MetronARC/metronarc/DESIGN/DATA/MT-056-SOP-001.pdf

1 | P a g e

Singapore, 179094
[Company Phone Number]
Co. Reg. No. 200918382G
Document No | : | MT-056-SOP-001 | STANDARD OPERATING
| : | March 5, 2025 | PROCEDURE Effective Date
Revision Status | : | | Mechanical Installation on Sparc CNC

Department : Engineering

### 1. PURPOSE :

to know how to assemble each hardware part on sparc cnc.

including what types of components are needed.

### 2. SCOPE :

This document outlines the step-by-step procedure for installing each mechanical sparc cnc part.

### 3. PROCEDURE DETAILS :

No. | Picture | Detail

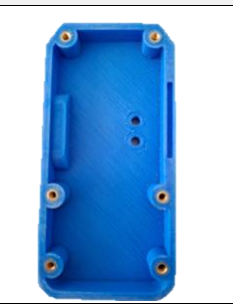
[picture p1: figure]

1 | | Install a 6-piece M4 Nut on the bolt side.

2 | P a g e

[Company Phone Number]
Co. Reg. No. 200918382G

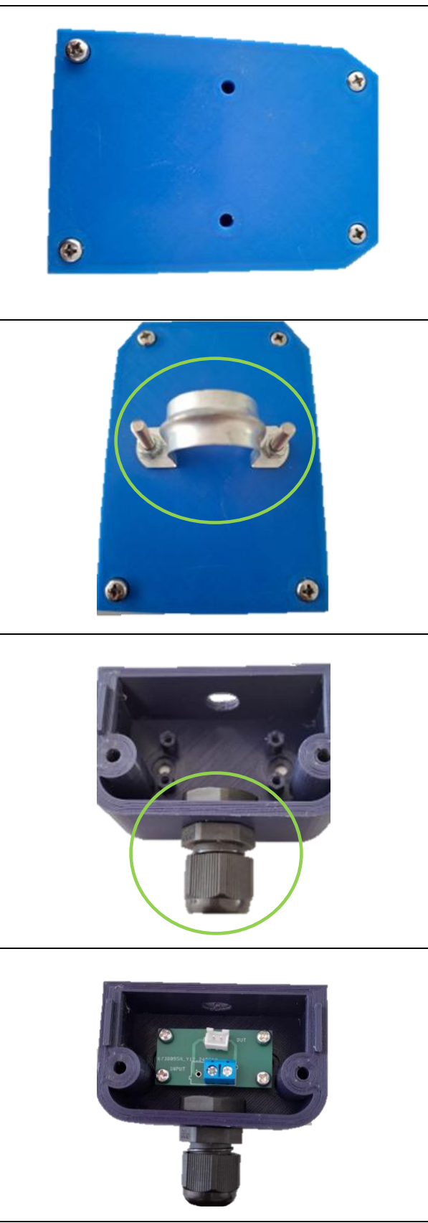
[picture p2: figure]

2 | Install M4 bolts on all 4 sides of the base
4 | Installing omega clamp with 2 M4 bolts.
5 | Installing PG9 at the bottom of the base terminal
| Attach the terminal PCB using M3 bolts on all four sides.

3 | P a g e

[Company Phone Number]
Co. Reg. No. 200918382G

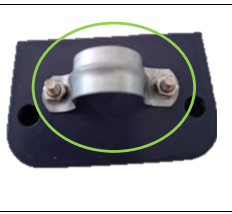
[picture p3: figure]

6 | Attach the omega clamp with the M4 bolt to the rear side of the basse terminal.
