MetronARC/metronarc/DESIGN/DATA/MT-056-SOP-002.pdf

1 | P a g e

Singapore, 179094
[Company Phone Number]
Co. Reg. No. 200918382G
Document No | : | MT-056-SOP-002 | STANDARD OPERATING
| : | March 5, 2025 | PROCEDURE Effective Date
Revision Status | : | | Installation of Components on Sparc CNC PCB

Department : Engineering

### 1. PURPOSE :

to find out the installation of components on Sparc CNC PCBs both PCBs using batteries and PCBs without batteries.

### 2. SCOPE :

This document describes each process and direction of attaching each component to the PCB.

### 3. PROCEDURE DETAILS:

No. | Picture | Detail

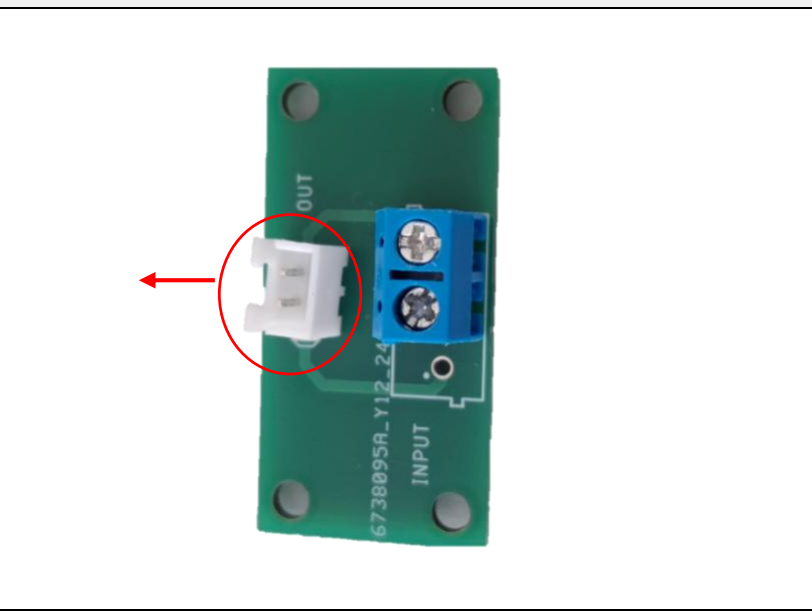
[picture p4: figure]

1 | | Attach the 2-pin JST terminal to the Output pin in the direction of the arrow.

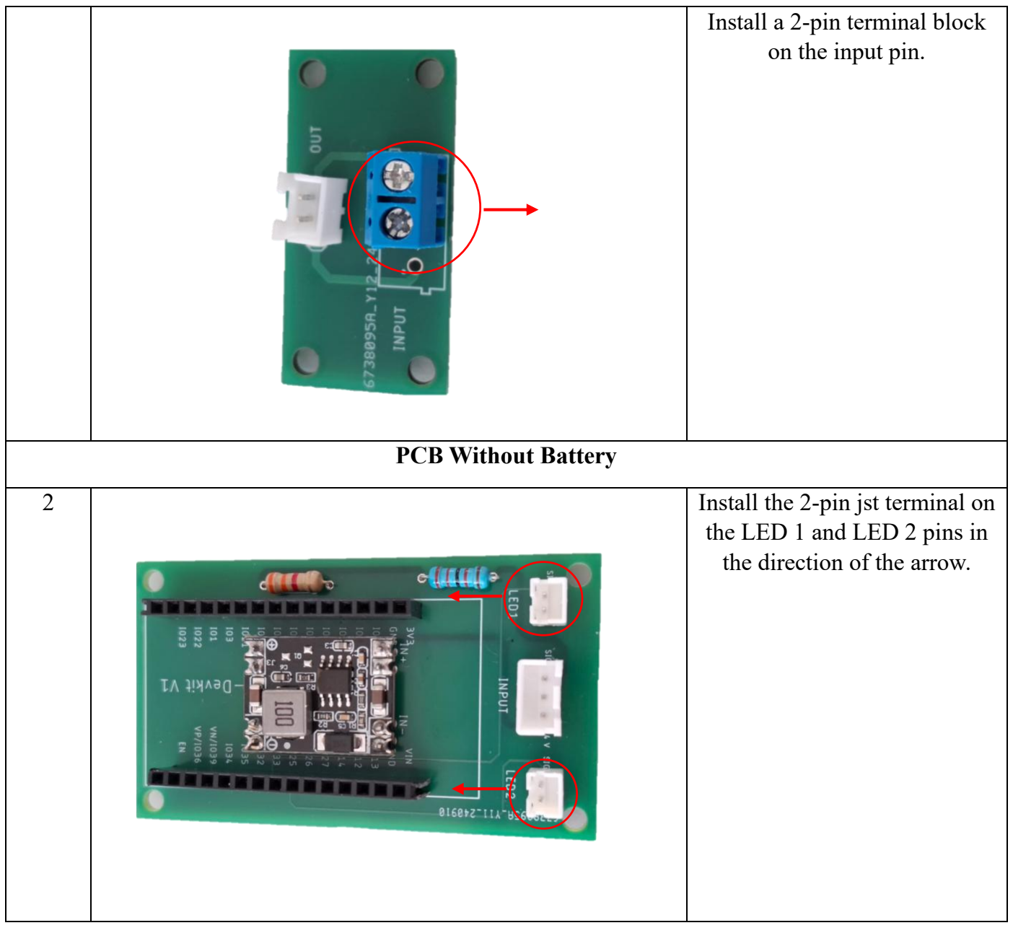
[picture p5: figure]
Install a 2-pin terminal block on the input pin.; PCB Without Battery; Install the 2-pin jst terminal on; the LED 1 and LED 2 pins in the direction of the arrow.

2 | P a g e

[Company Phone Number]
Co. Reg. No. 200918382G

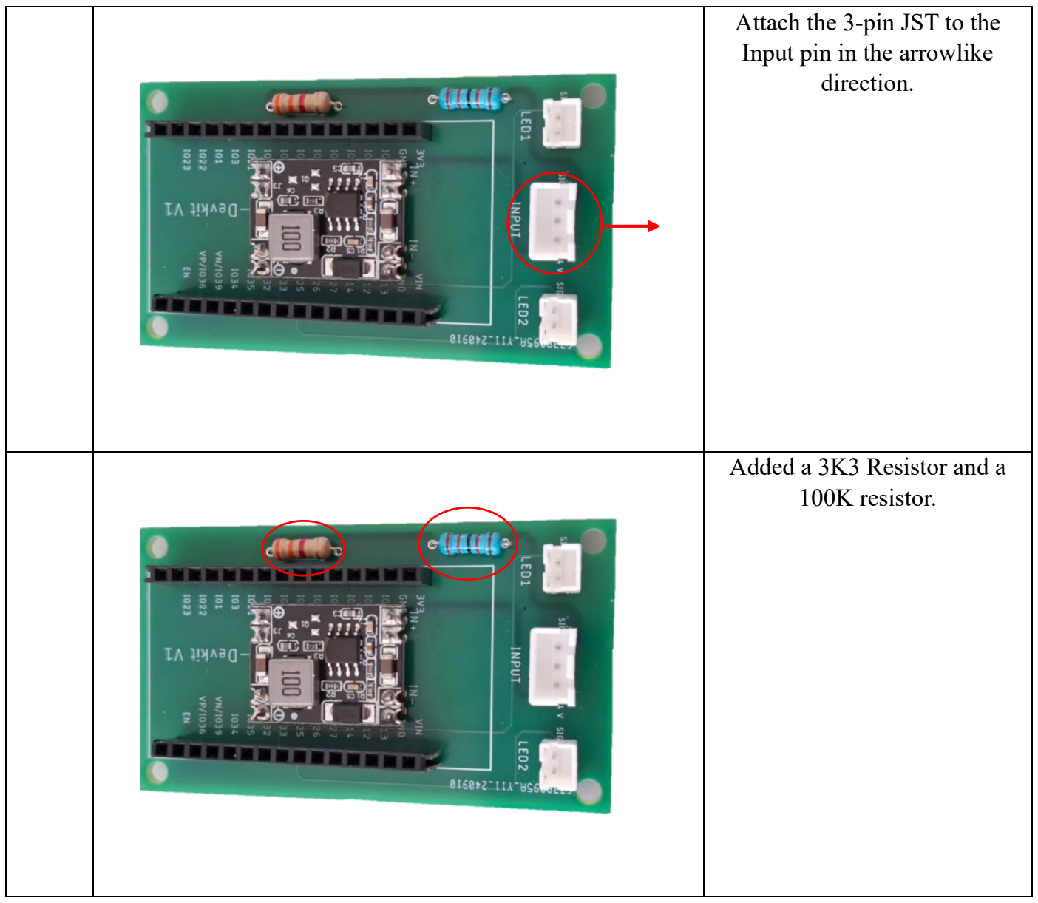
[picture p6: figure]

3 | P a g e

[Company Phone Number]
Co. Reg. No. 200918382G

Attach the 3-pin JST to the Input pin in the arrowlike direction.

Added a 3K3 Resistor and a 100K resistor.

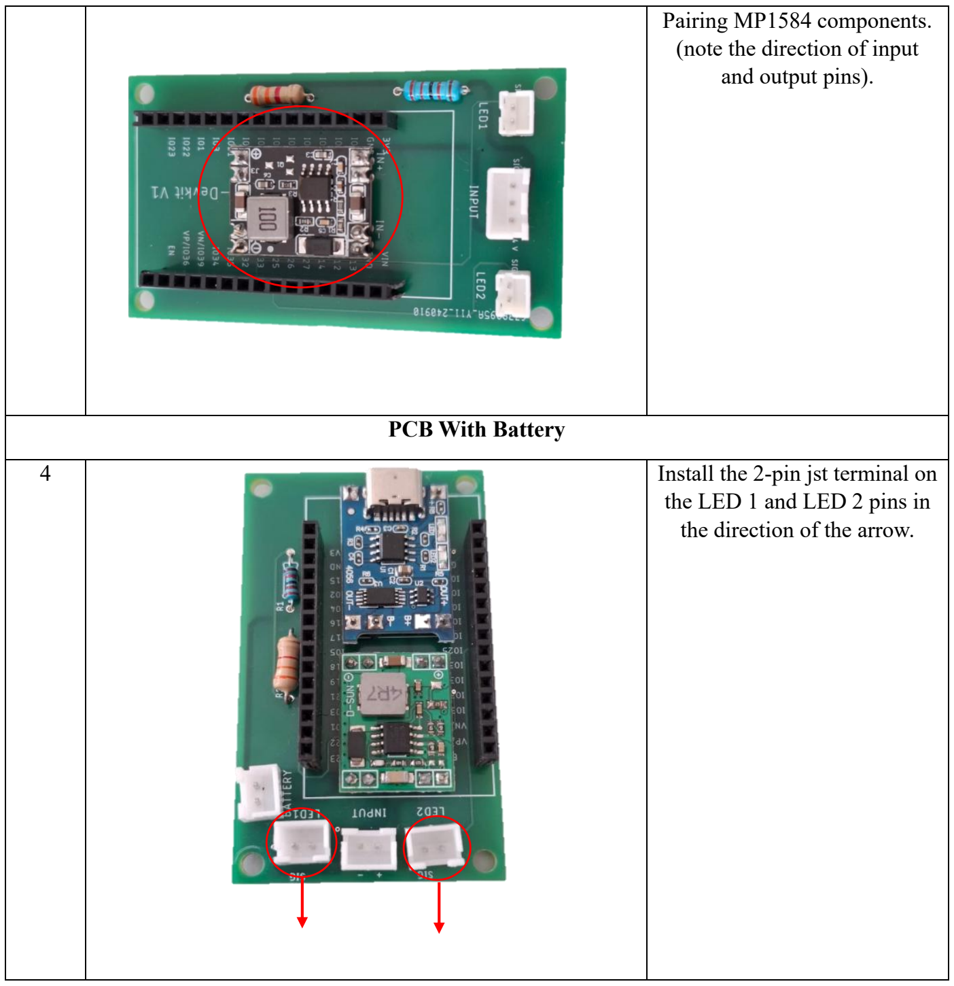
[picture p7: figure]
Pairing MP1584 components. (note the direction of input and output pins).; PCB With Battery; Install the 2-pin jst terminal on; the LED 1 and LED 2 pins in the direction of the arrow.

4 | P a g e

[Company Phone Number]
Co. Reg. No. 200918382G

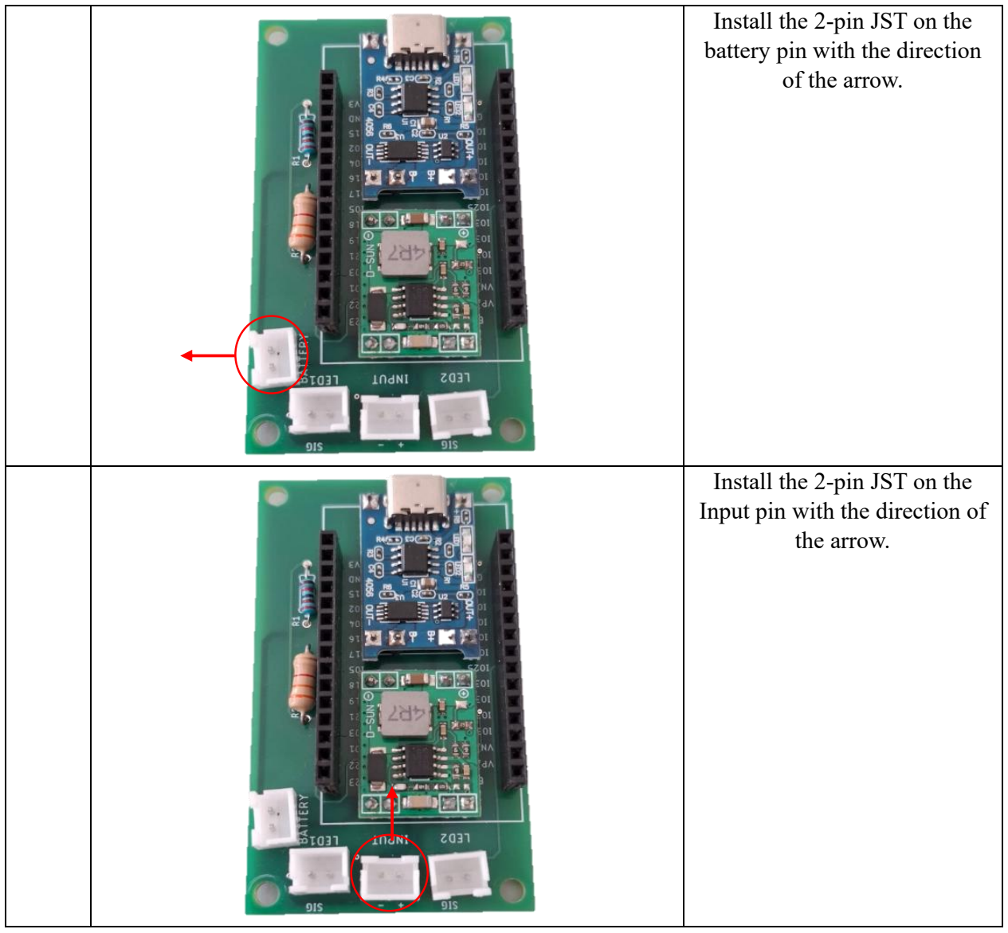
[picture p8: figure]

5 | P a g e

[Company Phone Number]
Co. Reg. No. 200918382G

Install the 2-pin JST on the battery pin with the direction of the arrow.

Install the 2-pin JST on the Input pin with the direction of the arrow.

6 | P a g e

[Company Phone Number]
Co. Reg. No. 200918382G

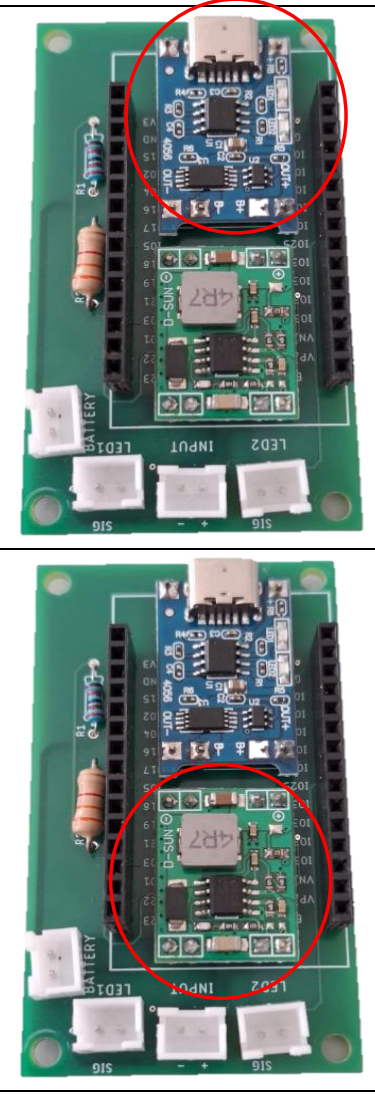
[picture p9: figure]

Install TP4056 components by paying attention to the input and output pin labels on the PCB.

Pairing MP1584 components. (note the direction of input and output pins).
