MetronARC/metronarc/DESIGN/GAMMA/Drawing/MTP-056-001-01.pdf

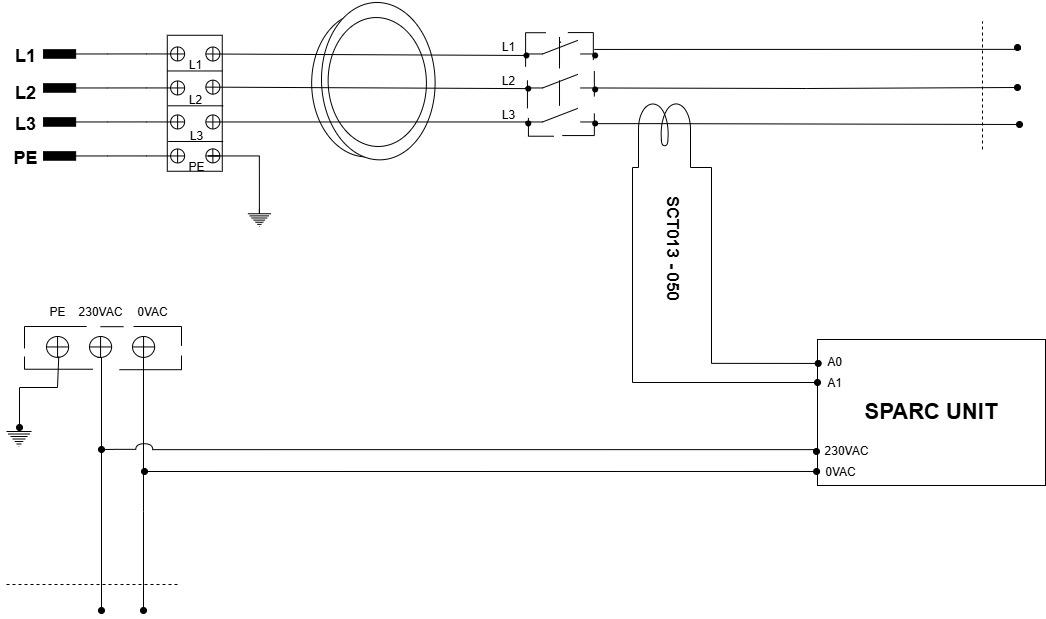
[picture p10: figure]

1 | 30-JAN-2025 | RDP | RR | RR | ISSUED FOR REVIEW
Revision | Date | Drawn By | Checked By | Approved By | Description of Revison
TECHNOLOGY | 1 North Bridge Road #18-06 High Street Centre

Singapore, 179094

Tittle:

### SPARC GAMMA Installation Wiring Diagram

Drawing Number: | Size :
MTP-056-001-01 | A4
