MetronARC/metronarc/DESIGN/CNC/Drawing/Image/Draw Isometric.JPG

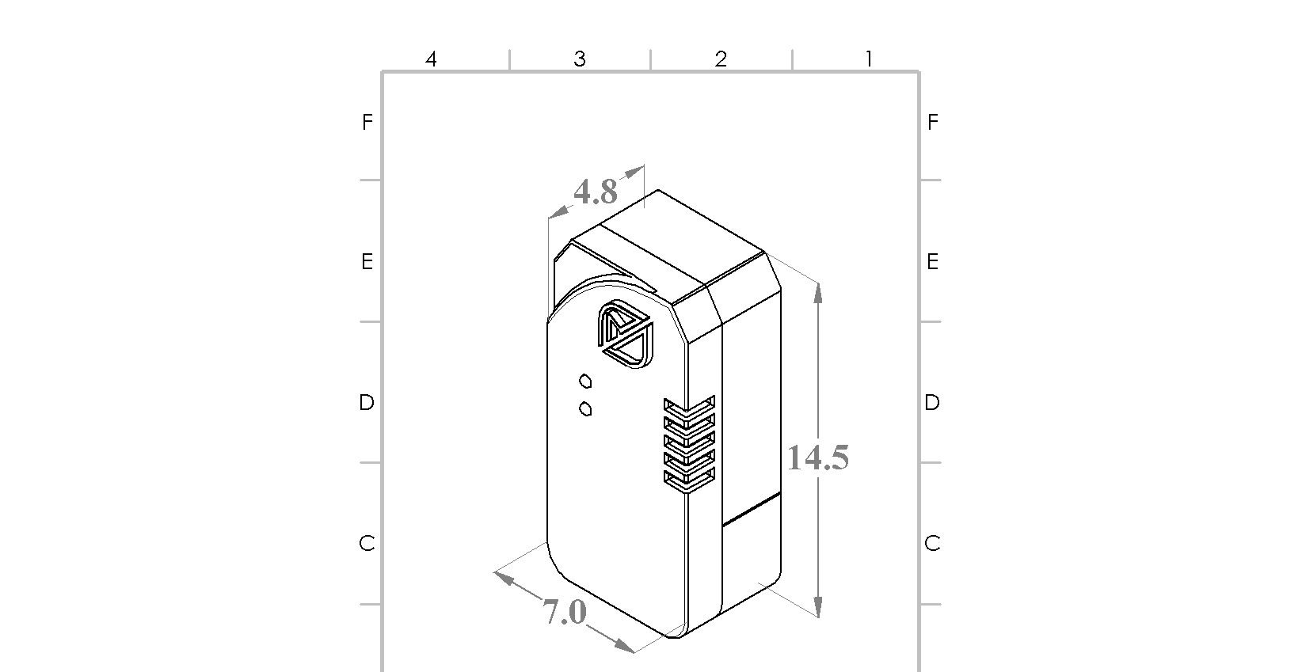
DESIGN/CNC/Drawing/Image/Draw Isometric.JPG
