MetronARC/metronarc/DESIGN/CNC/Drawing/Image/Drawing tampak belakang.JPG

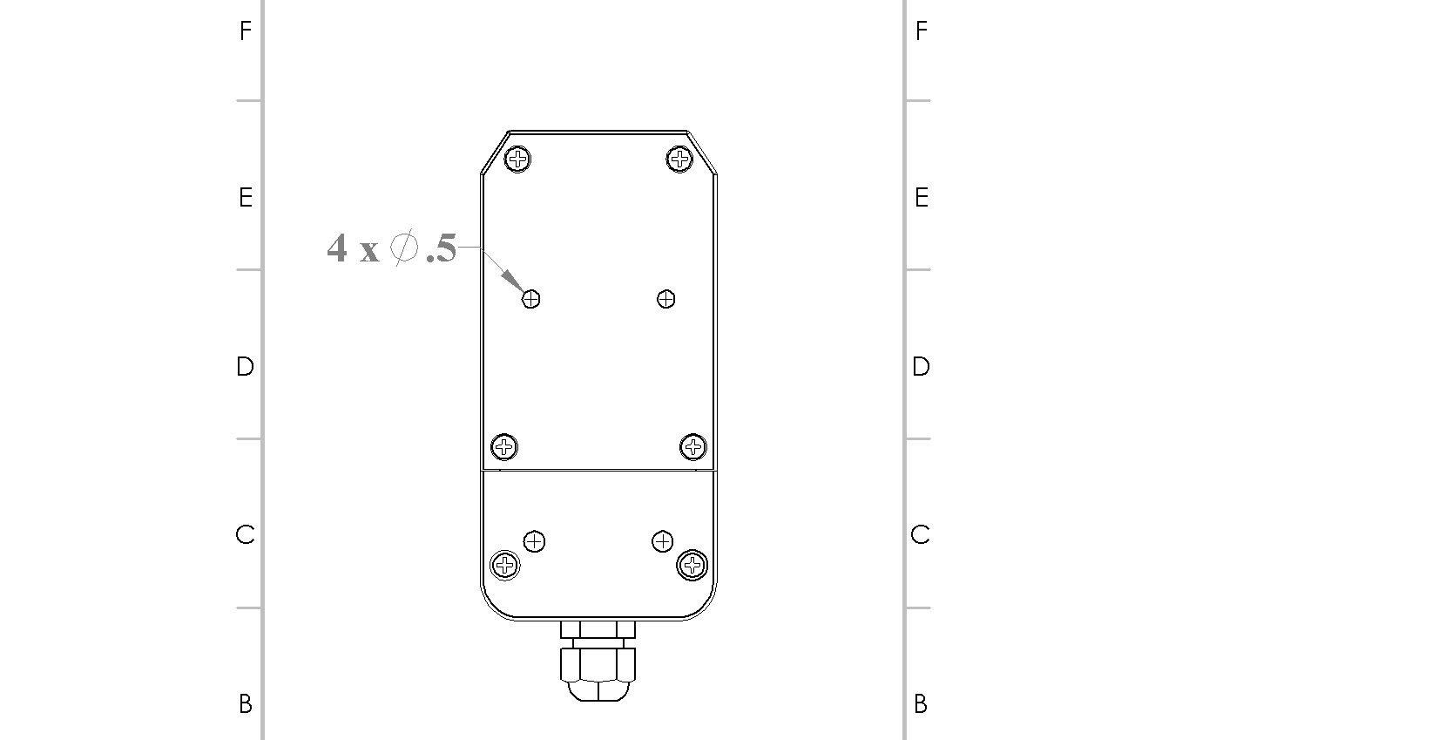
DESIGN/CNC/Drawing/Image/Drawing tampak belakang.JPG
