MetronARC/metronarc/DESIGN/CNC/Drawing/Image/Isometric.JPG

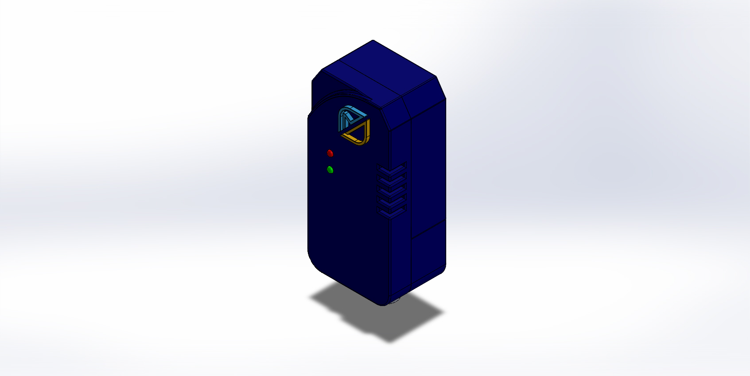
DESIGN/CNC/Drawing/Image/Isometric.JPG
