MetronARC/metronarc/DESIGN/CNC/Drawing/Image/Tampak Depan.JPG

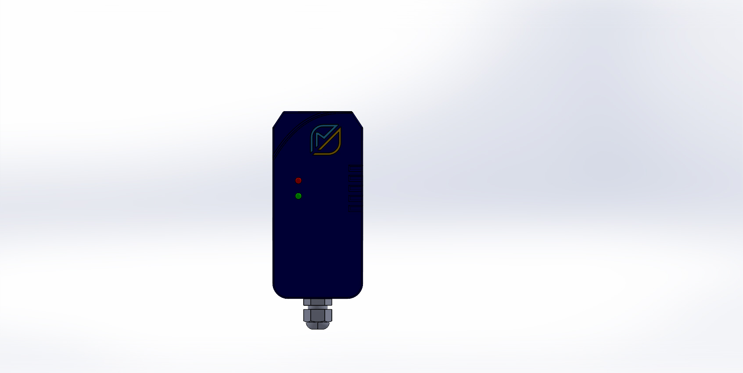
DESIGN/CNC/Drawing/Image/Tampak Depan.JPG
