MetronARC/metronarc/DESIGN/CNC/Drawing/Image/Tampak Samping.JPG

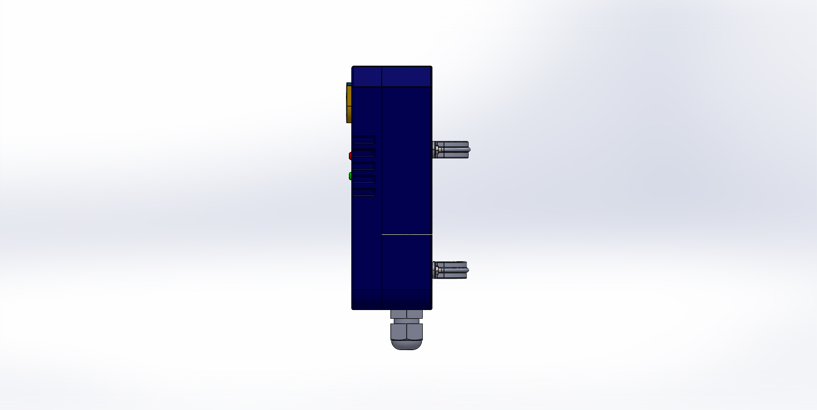
DESIGN/CNC/Drawing/Image/Tampak Samping.JPG
