MetronARC/metronarc/DESIGN/GAMMA/Drawing/Deoan (tampak LED).JPG

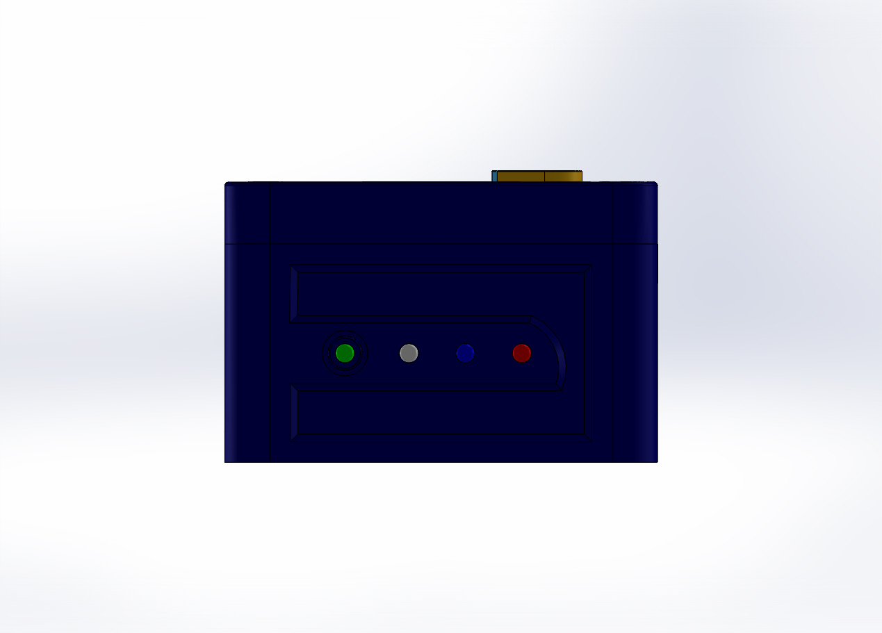
DESIGN/GAMMA/Drawing/Deoan (tampak LED).JPG
