MetronARC/metronarc/DESIGN/GAMMA/Drawing/Drawing Base.JPG

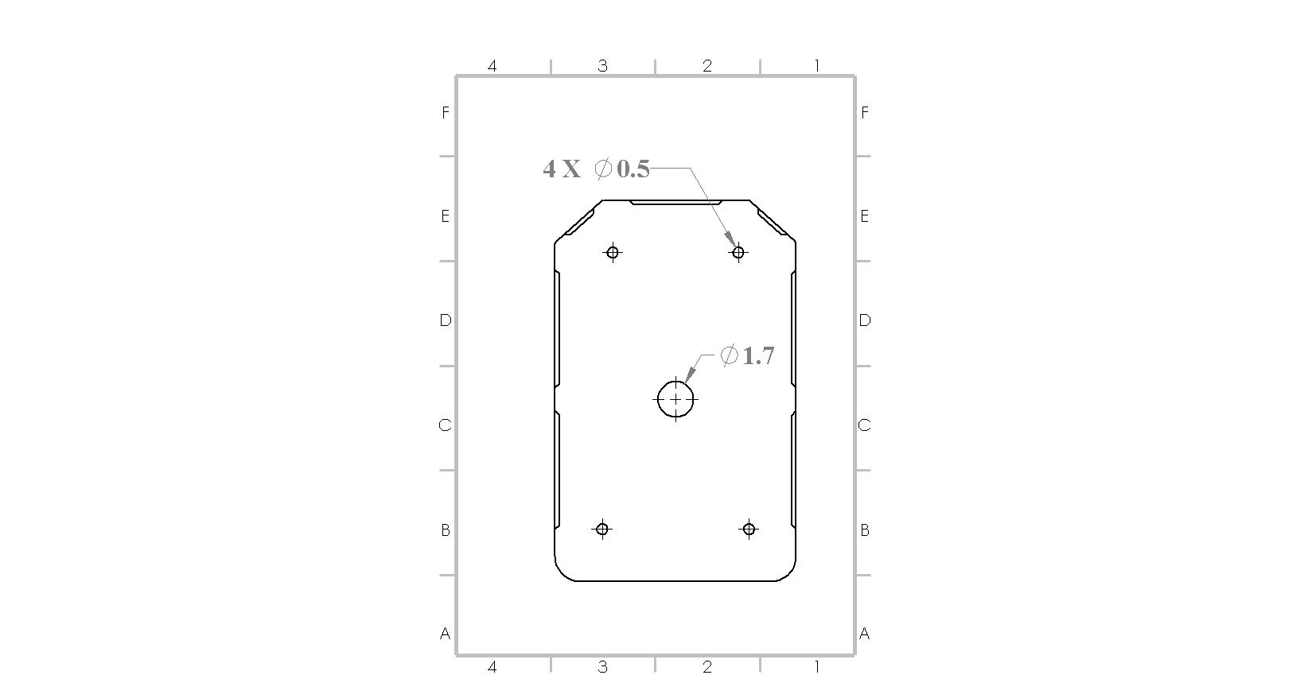
DESIGN/GAMMA/Drawing/Drawing Base.JPG
