MetronARC/metronarc/DESIGN/GAMMA/Drawing/Drawing Depan  (tampak LED).JPG

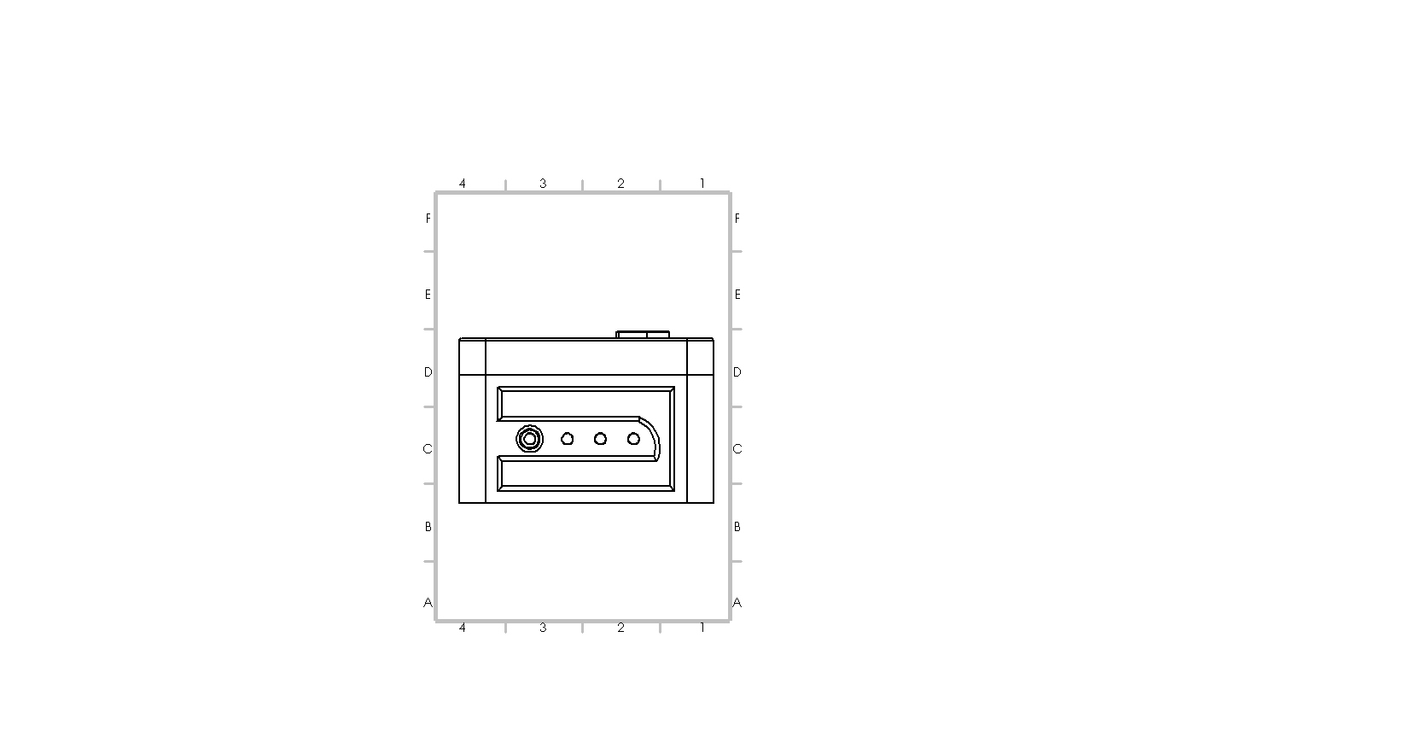
DESIGN/GAMMA/Drawing/Drawing Depan (tampak LED).JPG
