MetronARC/metronarc/DESIGN/GAMMA/Drawing/Drawing Isometric.JPG

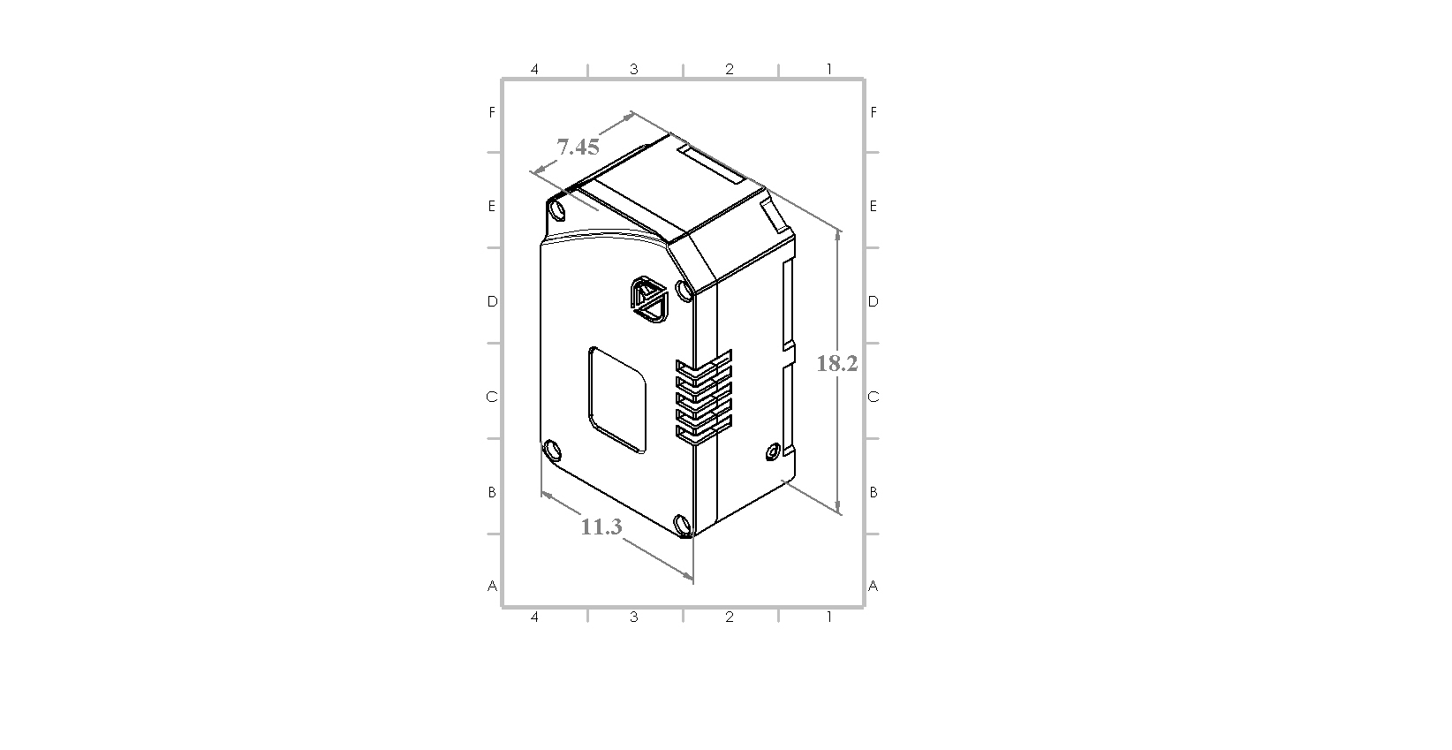
DESIGN/GAMMA/Drawing/Drawing Isometric.JPG
