MetronARC/metronarc/DESIGN/BETA/File STL/Template TOP.STL

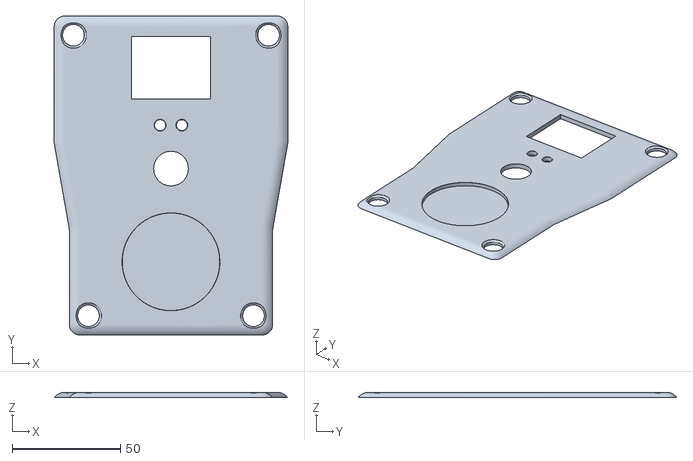
[picture p20: CAD file, 2025-04-08]
DESIGN/BETA/File STL/Template TOP.STL
107.7 x 147.1 x 2.50
