MetronARC/metronarc/DESIGN/CNC/SolidWorks file/Top Box terminal.SLDPRT

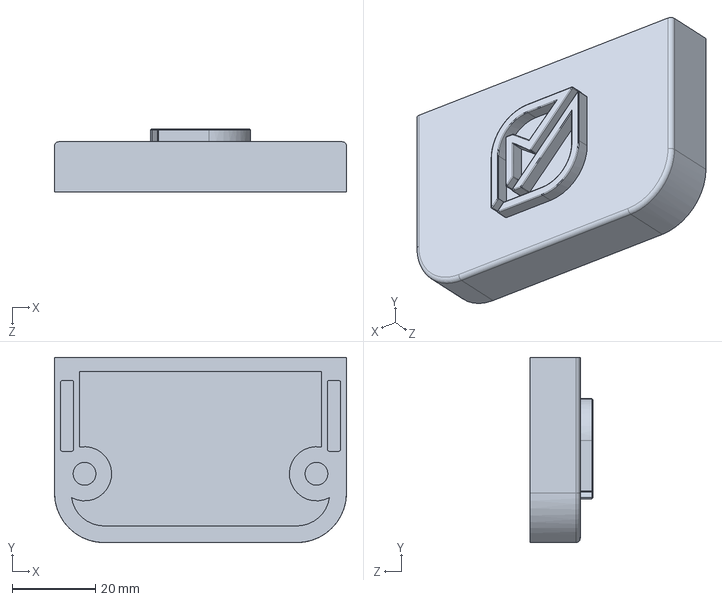
[picture p21: CAD file, 2025-04-08]
DESIGN/CNC/SolidWorks file/Top Box terminal.SLDPRT
70.0 x 44.4 x 15.0 mm
