MetronARC/metronarc/DESIGN/CNC/STL/Bracket.STL

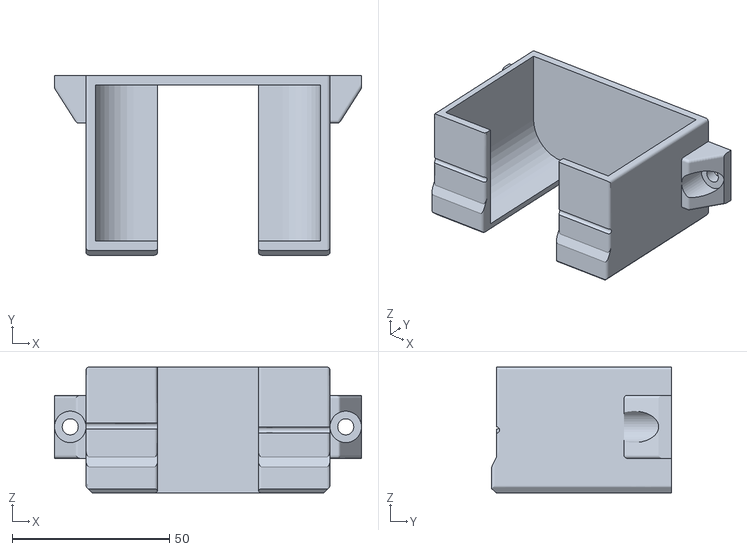
[picture p22: CAD file, 2024-12-26]
DESIGN/CNC/STL/Bracket.STL
97.5 x 57.0 x 40.0
