MetronARC/metronarc/DESIGN/GAMMA/Solidworks file/Spark .M REV.SLDPRT

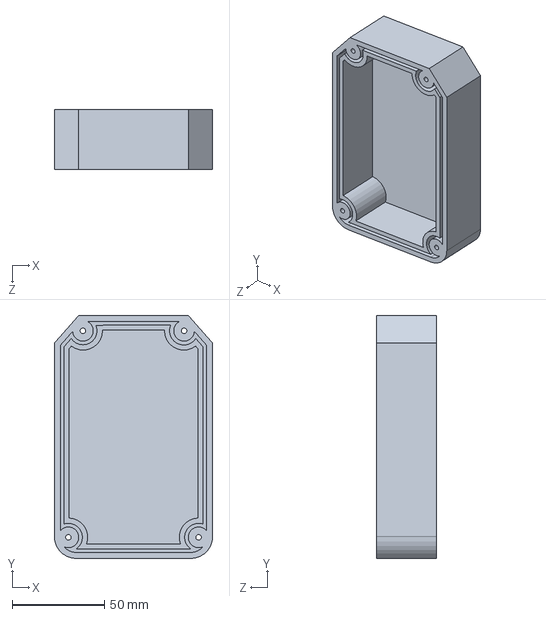
[picture p23: CAD file, 2025-04-08]
DESIGN/GAMMA/Solidworks file/Spark .M REV.SLDPRT
86.0 x 131.9 x 32.5 mm
