MetronARC/metronarc/DESIGN/GAMMA/STL/Spark .M REV2.STL

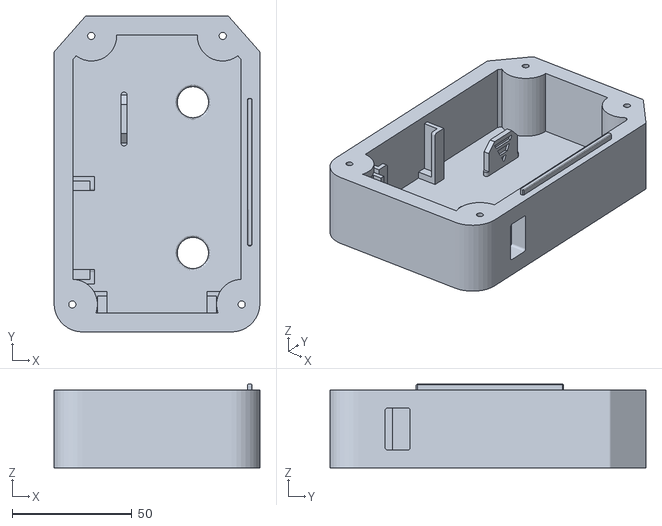
[picture p24: CAD file, 2024-10-15]
DESIGN/GAMMA/STL/Spark .M REV2.STL
86.0 x 131.9 x 35.0
