MetronARC/metronarc/DESIGN/OILID/DESIGN/BASE_Mini Gamma QR.STL

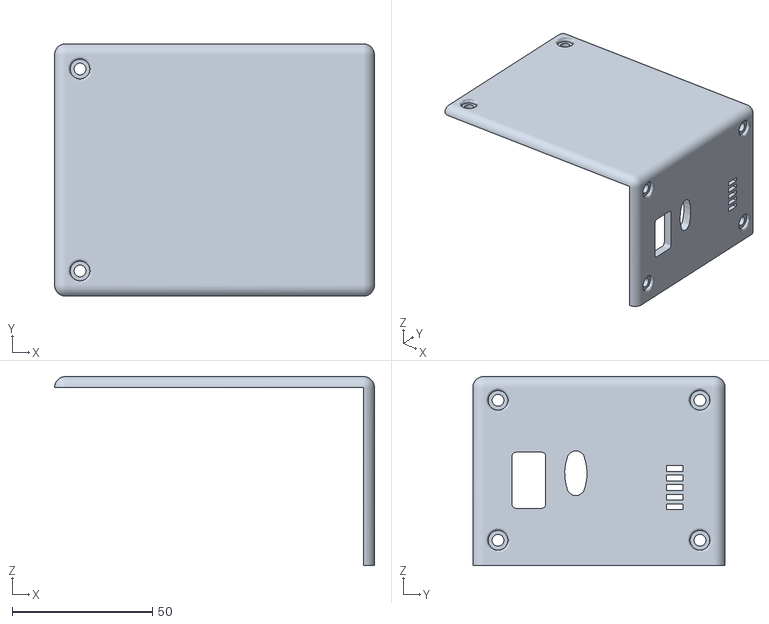
[picture p25: CAD file, 2025-02-19]
DESIGN/OILID/DESIGN/BASE_Mini Gamma QR.STL
114.1 x 90.0 x 67.4
