MetronARC/metronarc/PCB/3D/PCB Terminal.step

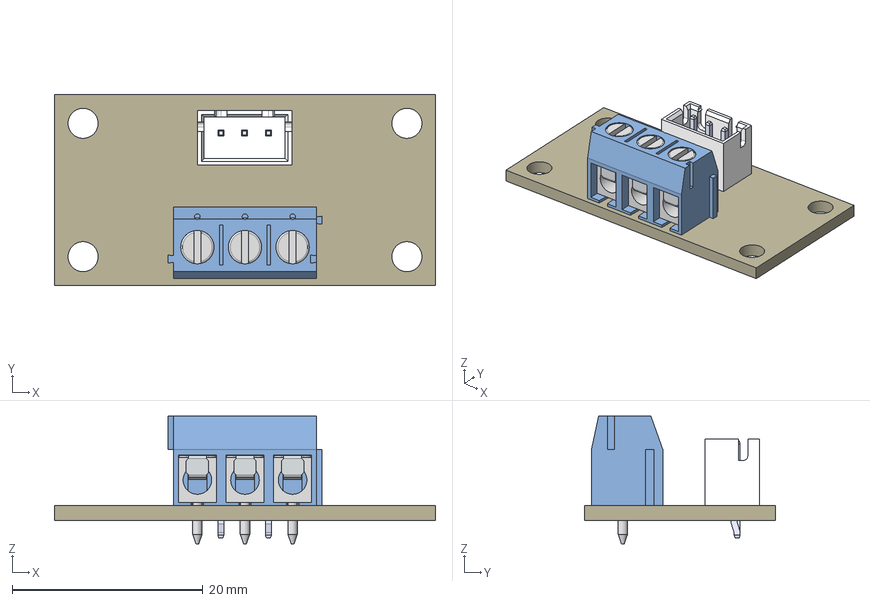
[picture p26: CAD file, 2024-09-09]
PCB/3D/PCB Terminal.step
40.0 x 20.0 x 13.4 mm
Board
Packages
6911027100xx_CAGE x 3
6911027100xx_PIN x 3
6911027100xx_VIS x 3
BxB-XH-A_03
