MetronARC/metronarc/PCB/SCHEMATIC/GAMMA/SCHEMATIC/3D File/SPARC_Gamma_3D PCB Layout v2.stl

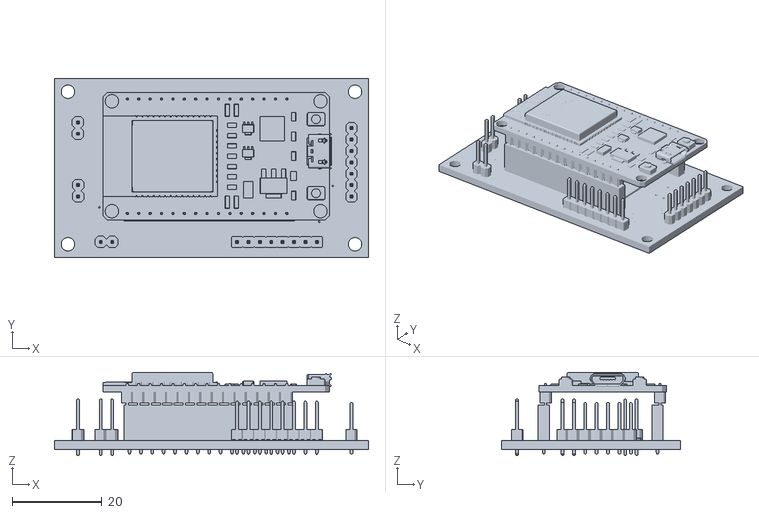
[picture p27: CAD file, 2024-09-09]
PCB/SCHEMATIC/GAMMA/SCHEMATIC/3D File/SPARC_Gamma_3D PCB Layout v2.stl
70.0 x 40.0 x 18.5
