MetronARC/metronarc/DESIGN/BETA/File STL/BASE.STL

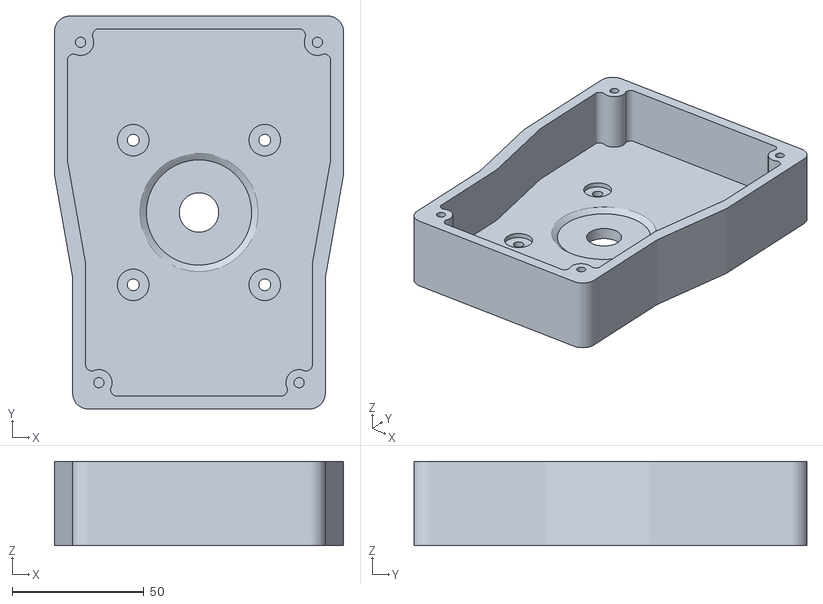
[picture p28: CAD file, 2025-04-08]
DESIGN/BETA/File STL/BASE.STL
110.0 x 149.4 x 32.0
