MetronARC/metronarc/DESIGN/CNC/SolidWorks file/TOP.SLDPRT

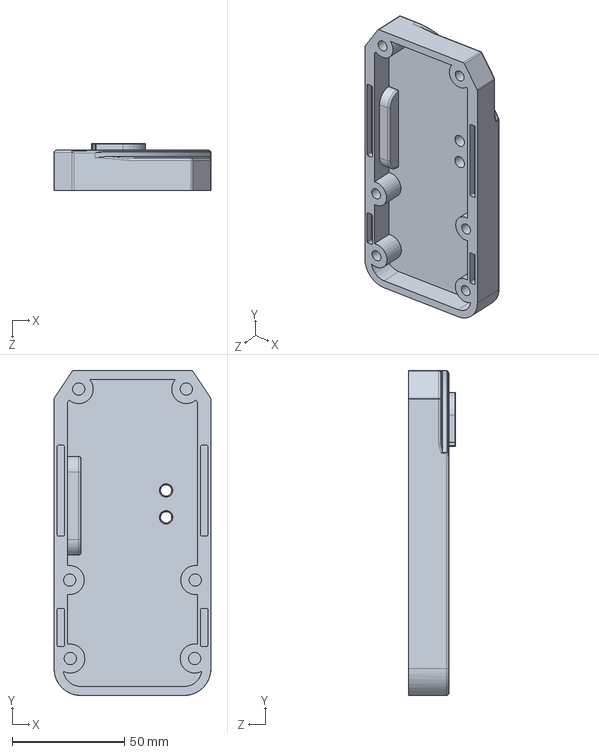
[picture p29: CAD file, 2025-04-08]
DESIGN/CNC/SolidWorks file/TOP.SLDPRT
70.0 x 145.0 x 21.0 mm
