MetronARC/metronarc/DESIGN/CNC/STL/Rev1_L_Con.STL

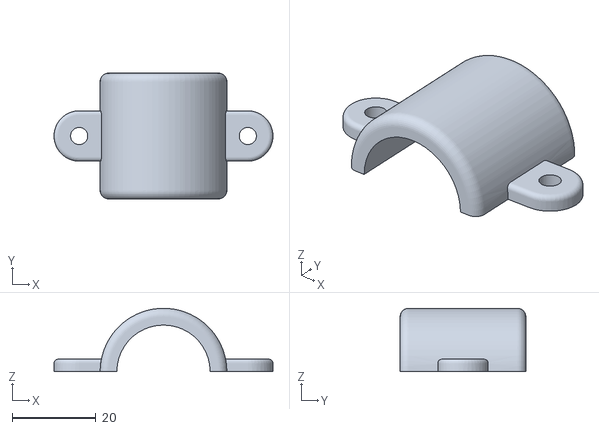
[picture p30: CAD file, 2024-12-11]
DESIGN/CNC/STL/Rev1_L_Con.STL
52.2 x 30.0 x 15.1
