MetronARC/metronarc/DESIGN/GAMMA/Solidworks file/TOP.M REV.SLDPRT

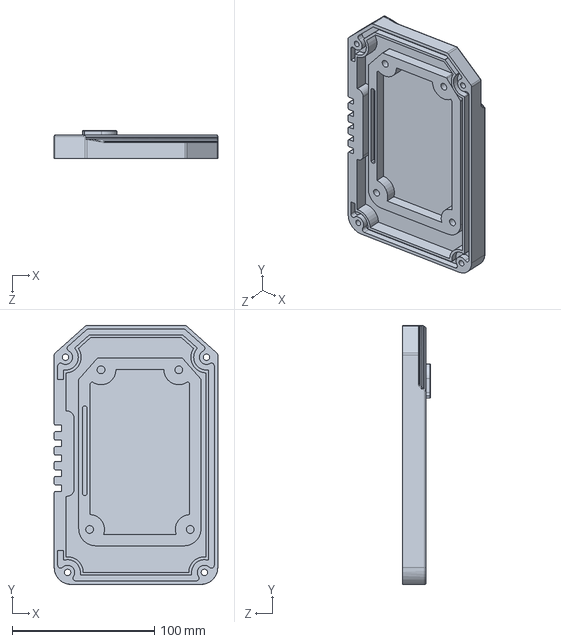
[picture p31: CAD file, 2025-04-08]
DESIGN/GAMMA/Solidworks file/TOP.M REV.SLDPRT
115.0 x 181.9 x 19.5 mm
