MetronARC/metronarc/DESIGN/GAMMA/STL/BASE.M REV2.STL

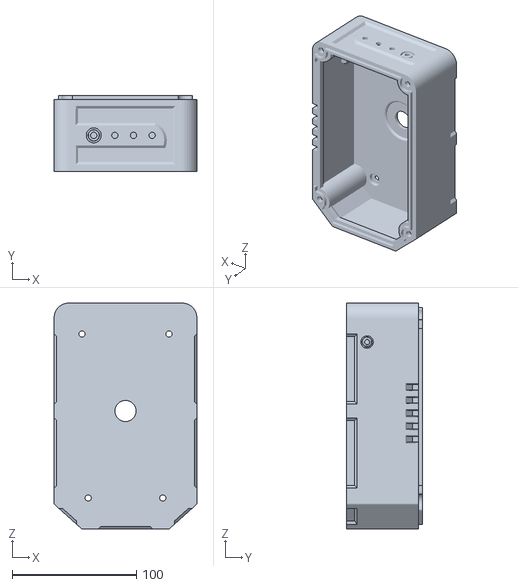
[picture p32: CAD file, 2024-10-15]
DESIGN/GAMMA/STL/BASE.M REV2.STL
115.0 x 61.0 x 181.9
