MetronARC/metronarc/DESIGN/OILID/DESIGN/TOP_Mini Gamma QR.STL

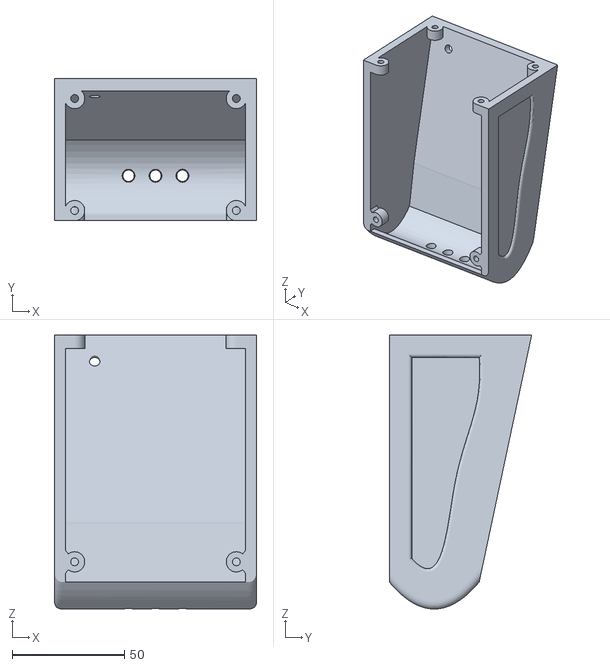
[picture p33: CAD file, 2025-02-19]
DESIGN/OILID/DESIGN/TOP_Mini Gamma QR.STL
90.0 x 63.4 x 122.0
