MetronARC/metronarc/DESIGN/BETA/File STL/Template BASE.STL

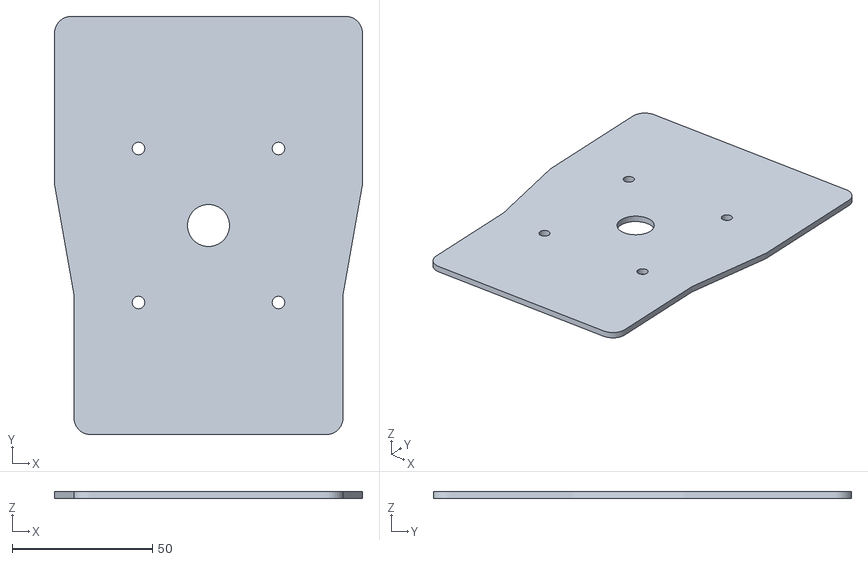
[picture p34: CAD file, 2025-04-08]
DESIGN/BETA/File STL/Template BASE.STL
110.0 x 149.4 x 2.50
