MetronARC/metronarc/DESIGN/CNC/SolidWorks file/Box Terminal.SLDPRT

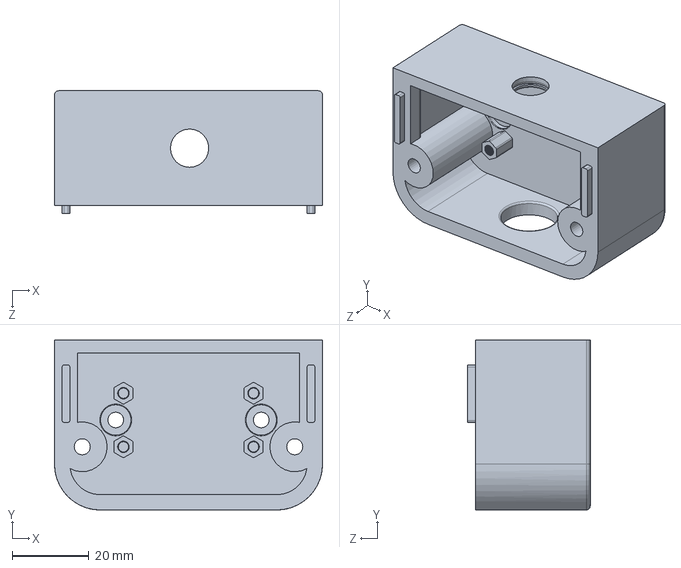
[picture p35: CAD file, 2025-04-08]
DESIGN/CNC/SolidWorks file/Box Terminal.SLDPRT
70.0 x 44.4 x 32.0 mm
