MetronARC/metronarc/DESIGN/CNC/STL/Rev1_R_Con.STL

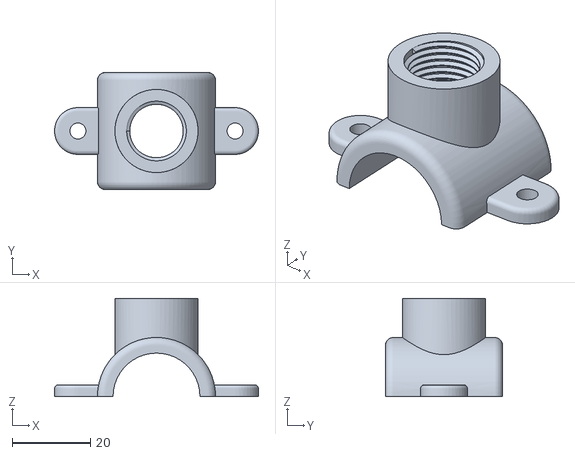
[picture p36: CAD file, 2024-12-11]
DESIGN/CNC/STL/Rev1_R_Con.STL
52.2 x 30.0 x 25.1
