MetronARC/metronarc/DESIGN/GAMMA/STL/TOP.M REV2.STL

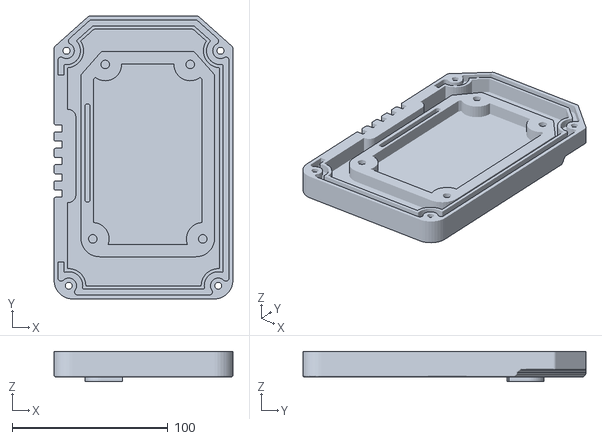
[picture p37: CAD file, 2024-10-15]
DESIGN/GAMMA/STL/TOP.M REV2.STL
115.0 x 181.9 x 19.5
