MetronARC/metronarc/DESIGN/OILID/DESIGN/Gamma base.STL

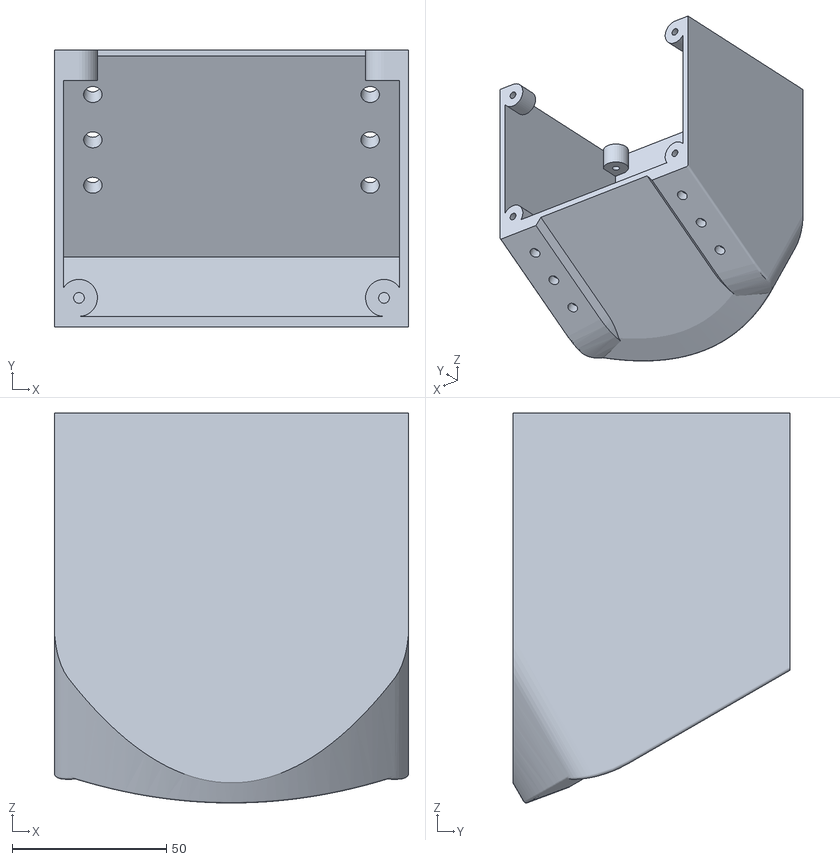
[picture p38: CAD file, 2025-02-06]
DESIGN/OILID/DESIGN/Gamma base.STL
115.0 x 90.0 x 126.6
