MetronARC/metronarc/PCB/3D/PCB WITH BATTERY v1.step

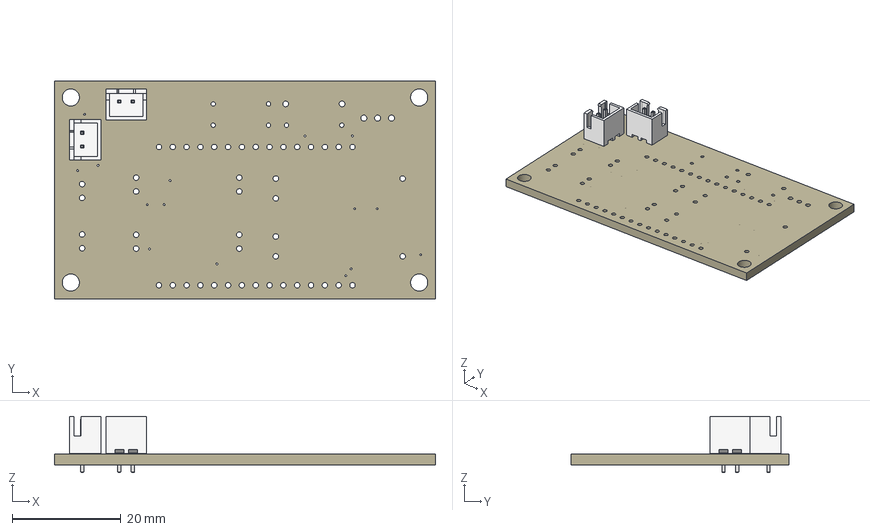
[picture p39: CAD file, 2024-09-09]
PCB/3D/PCB WITH BATTERY v1.step
70.0 x 40.0 x 10.3 mm
Board
Packages
JST 2 x 2
