MetronARC/metronarc/DESIGN/BETA/File STL/TOP.STL

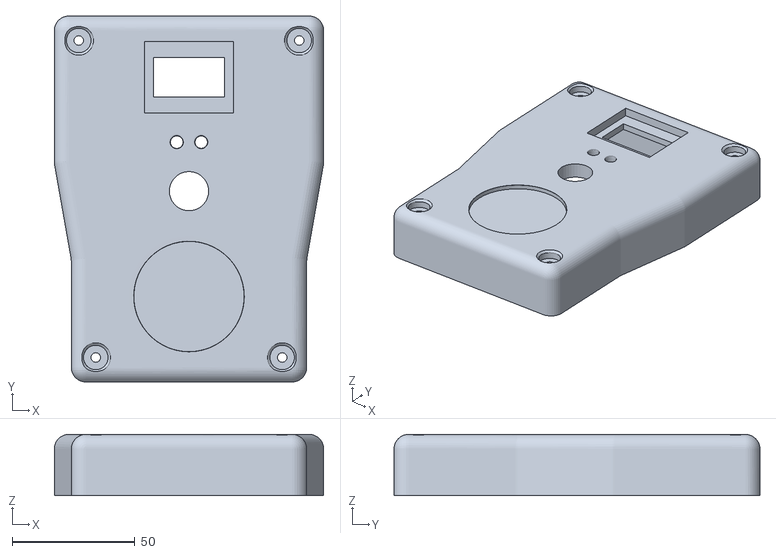
[picture p40: CAD file, 2025-04-08]
DESIGN/BETA/File STL/TOP.STL
110.0 x 149.4 x 25.0
