MetronARC/metronarc/DESIGN/CNC/SolidWorks file/BASE.SLDPRT

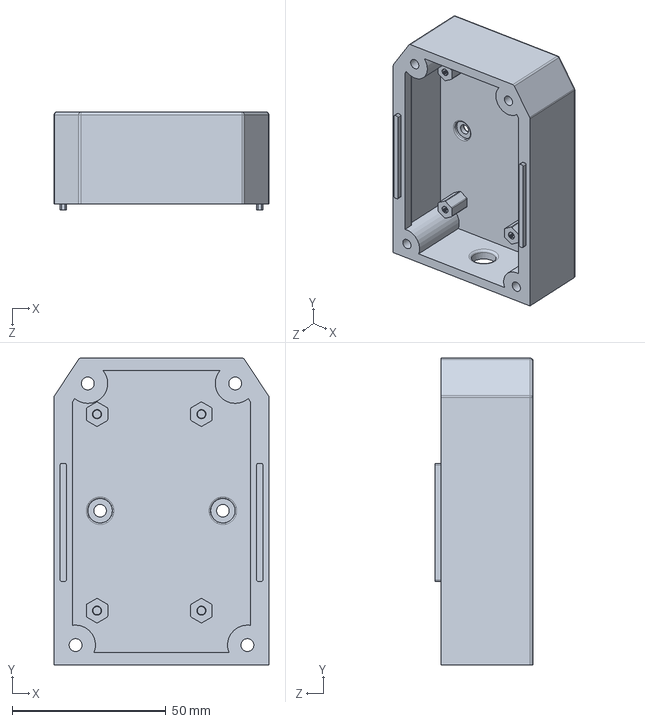
[picture p41: CAD file, 2025-04-08]
DESIGN/CNC/SolidWorks file/BASE.SLDPRT
70.0 x 100.0 x 32.0 mm
