MetronARC/metronarc/DESIGN/OILID/DESIGN/Gamma top.STL

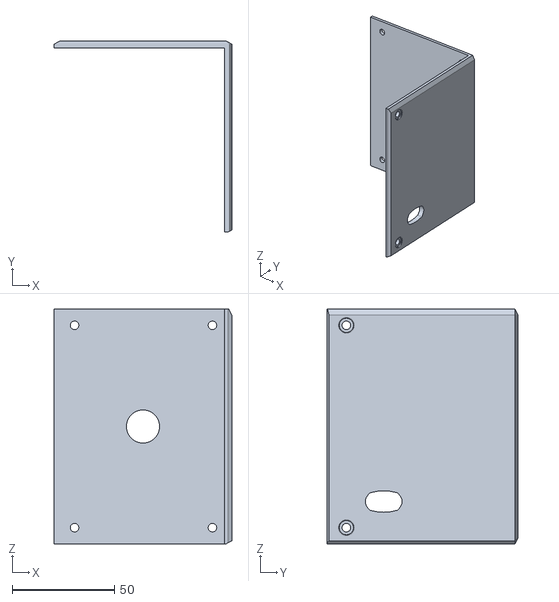
[picture p42: CAD file, 2025-02-06]
DESIGN/OILID/DESIGN/Gamma top.STL
87.0 x 93.5 x 115.0
