MetronARC/metronarc/DESIGN/CNC/STL/R_Con.STL

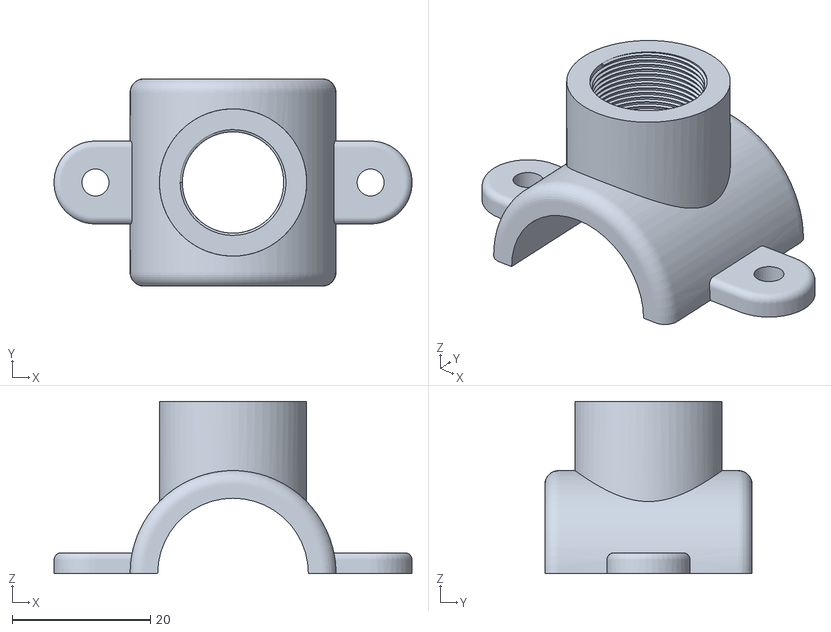
[picture p43: CAD file, 2024-12-06]
DESIGN/CNC/STL/R_Con.STL
51.8 x 30.0 x 24.9
