MetronARC/metronarc/(list of files, cad)

Other CAD files:
DESIGN/GAMMA/Solidworks file/BASE.M REV.SLDPRT
DESIGN/CNC/STL/L_Con.STL
DESIGN/CNC/Drawing/File Solidworks/Drawing CNC.SLDDRW
DESIGN/CNC/STL/BASE.STL
DESIGN/CNC/STL/Box Terminal.STL
DESIGN/CNC/STL/TOP.STL
DESIGN/CNC/STL/Top Box terminal.STL
DESIGN/GAMMA/Drawing/Drawing GAMA.SLDDRW
