MetronARC/metronarc/DESIGN/CNC/Drawing/Wiring diagram/MTR-056-001A-01.pdf

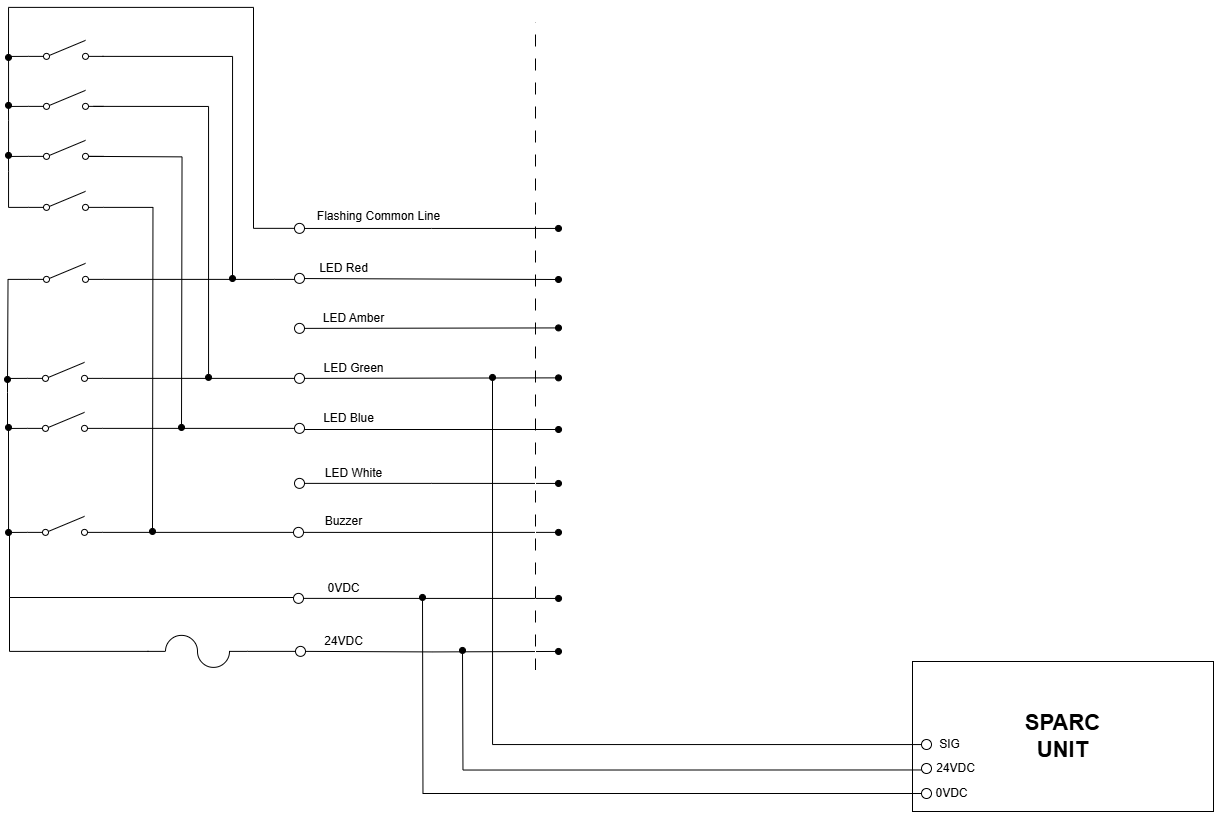
[picture p44: figure]

### PT. RONSTAN INTERNATIONAL

1 | 20-NOV-2024 | RDP | RR | RR | ISSUED FOR REVIEW
Revision | Date | Drawn By | Checked By | Approved By | Description of Revison
TECHNOLOGY | 1 North Bridge Road #18-06 High Street Centre

Singapore, 179094

Tittle:

### SPARC CNC Installation Wiring Diagram

Drawing Number: | Size :
MTR-056-001A-01 | A4
