MetronARC/metronarc/DESIGN/DATA/MT-056-SOP-003.pdf

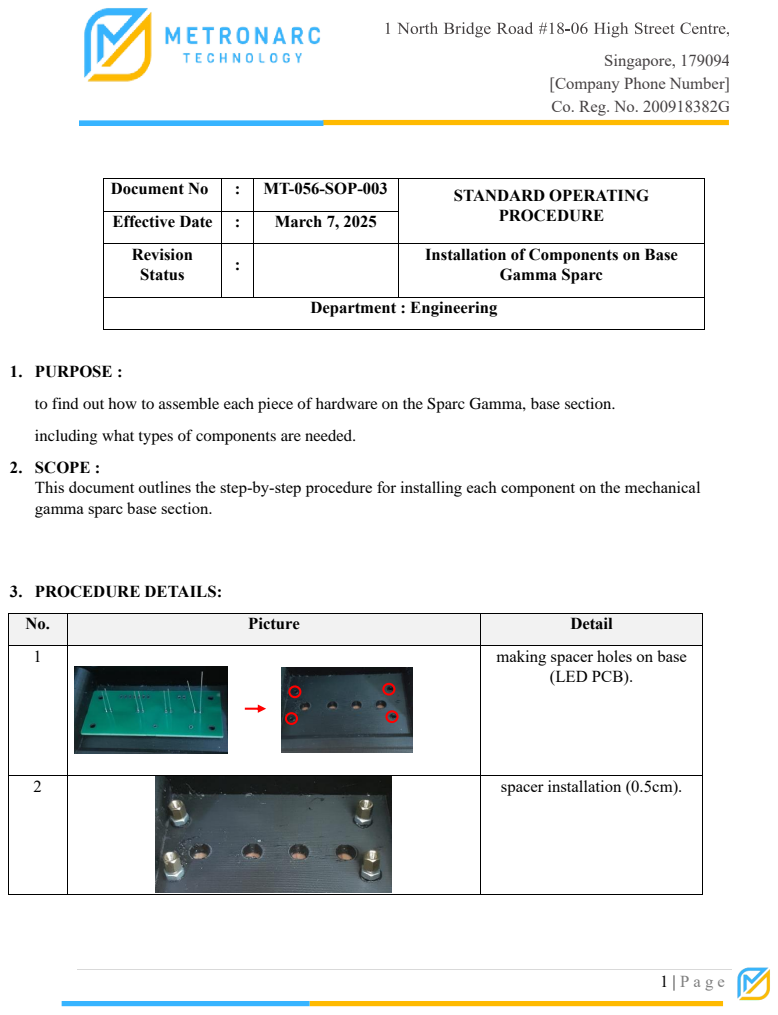
[picture p45: page 1]
Singapore, 179094; Department : Engineering; 1. PURPOSE :; 3. PROCEDURE DETAILS:

[Company Phone Number]
Co. Reg. No. 200918382G

Document No | : | MT-056-SOP-003 | STANDARD OPERATING
: | March 7, 2025 | PROCEDURE Effective Date

Revision Status | : | | Installation of Components on Base Gamma Sparc

to find out how to assemble each piece of hardware on the Sparc Gamma, base section.

including what types of components are needed.

2. SCOPE :
This document outlines the step-by-step procedure for installing each component on the mechanical
gamma sparc base section.

No. | Picture | Detail

1 | | making spacer holes on base (LED PCB).

2 | | spacer installation (0.5cm).

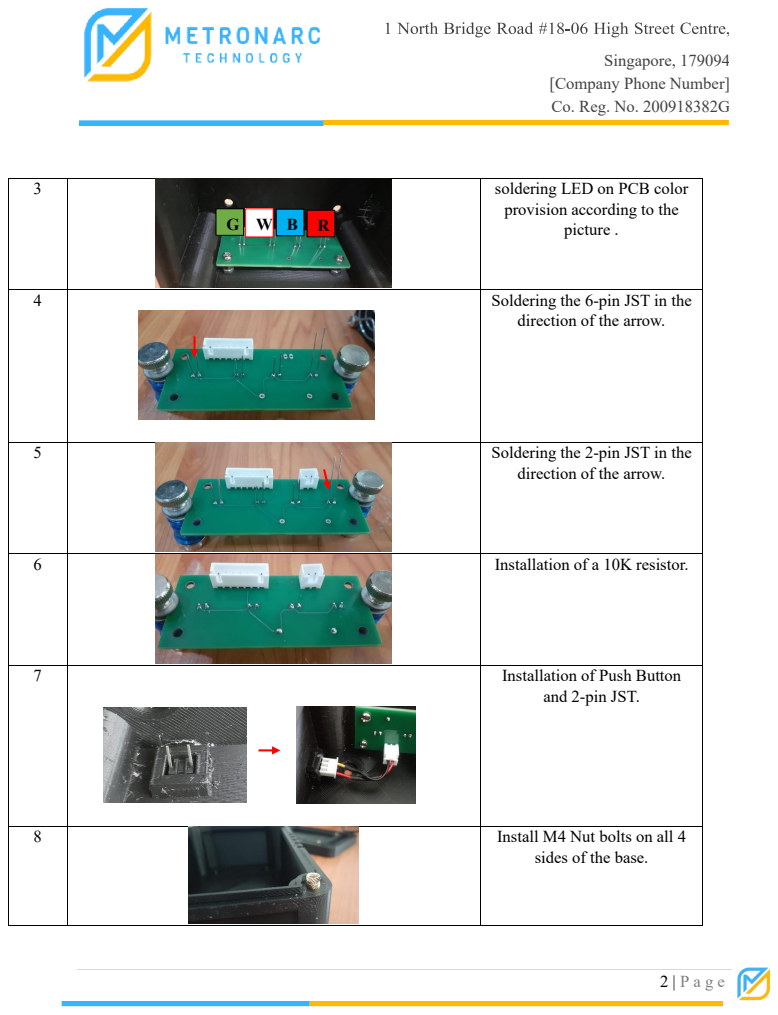
[picture p46: page 2]
Singapore, 179094

[Company Phone Number]
Co. Reg. No. 200918382G

3 | G W B R | soldering LED on PCB color provision according to the picture .

4 | | Soldering the 6-pin JST in the direction of the arrow.

5 | | Soldering the 2-pin JST in the direction of the arrow.

6 | | Installation of a 10K resistor.

7 | | Installation of Push Button and 2-pin JST.

8 | | Install M4 Nut bolts on all 4 sides of the base.
