MetronARC/metronarc/DESIGN/DATA/MT-056-SOP-004.pdf

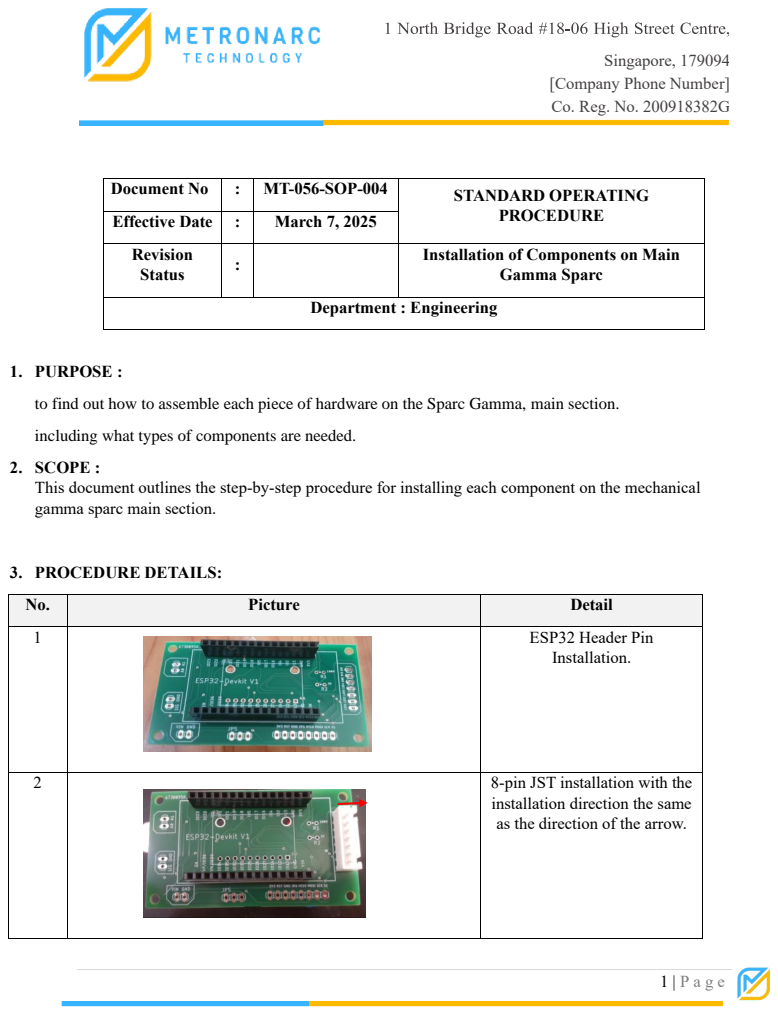
[picture p47: page 1]
Singapore, 179094; Department : Engineering; 1. PURPOSE :; 3. PROCEDURE DETAILS:

[Company Phone Number]
Co. Reg. No. 200918382G

Document No | : | MT-056-SOP-004 | STANDARD OPERATING
: | March 7, 2025 | PROCEDURE Effective Date

Revision Status | : | | Installation of Components on Main Gamma Sparc

to find out how to assemble each piece of hardware on the Sparc Gamma, main section.

including what types of components are needed.

2. SCOPE :
This document outlines the step-by-step procedure for installing each component on the mechanical
gamma sparc main section.

No. | Picture | Detail

1 | | ESP32 Header Pin Installation.

2 | | 8-pin JST installation with the installation direction the same as the direction of the arrow.

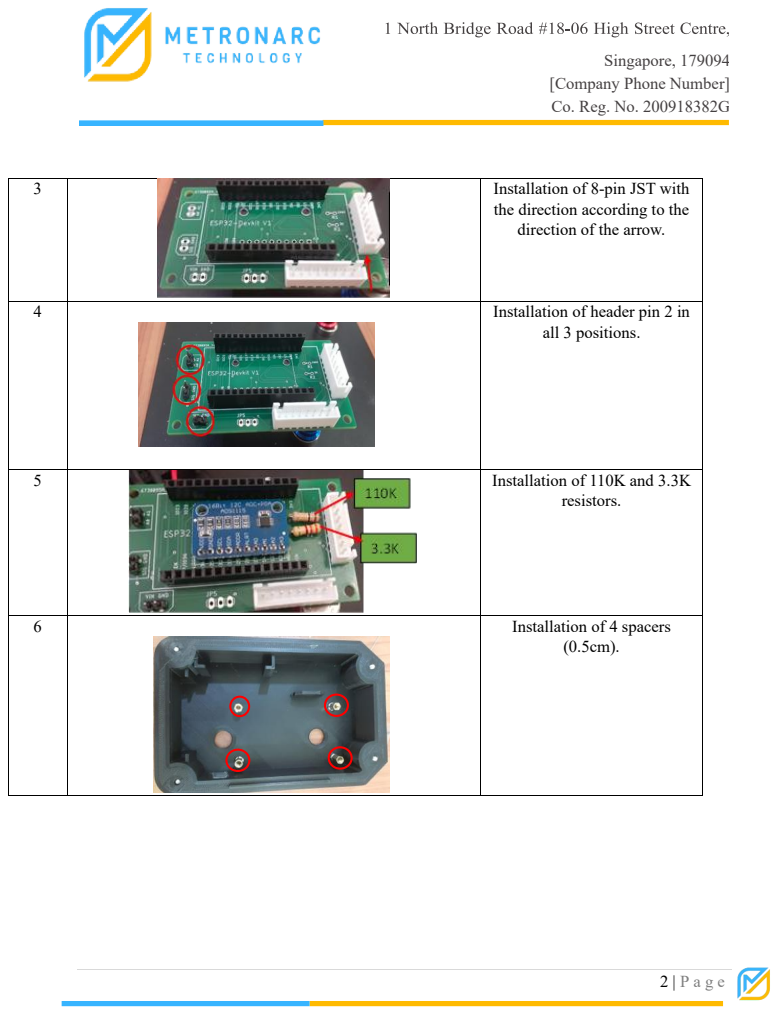
[picture p48: page 2]
Singapore, 179094

[Company Phone Number]
Co. Reg. No. 200918382G

3 | Installation of 8-pin JST with the direction according to the direction of the arrow.

4 | Installation of header pin 2 in all 3 positions.

5 | Installation of 110K and 3.3K resistors.

6 | Installation of 4 spacers (0.5cm).
