MetronARC/metronarc/DESIGN/DATA/ETIKET.PDF

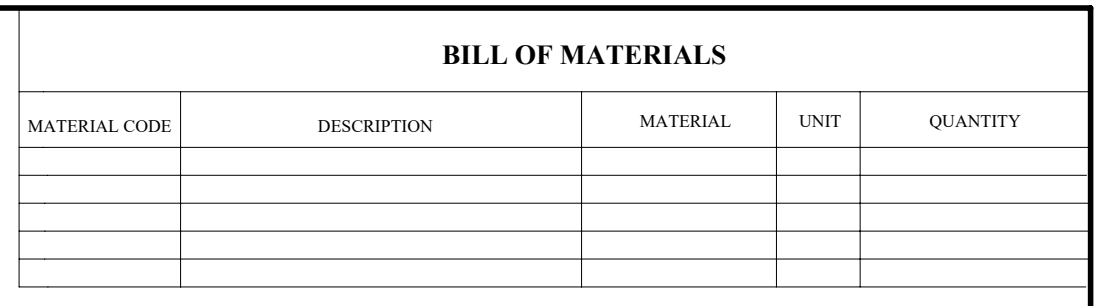
[picture p49: page 1]

BILL OF MATERIALS

MATERIAL CODE | DESCRIPTION | MATERIAL | UNIT | QUANTITY

NOTES:

Tittle

Rev | Date | Drawn | Chkd | Appr | Description
METRONARC TECHNOLOGY 1 North Bridge Road #18-16 High Street Center Singapore, 179094 | Scale NTS | Size A3 | Drawing no. | Rev.
