MetronARC/metronarc/DESIGN/CNC/Drawing/Drawing Instalation/MTR-056-002A-03.pdf

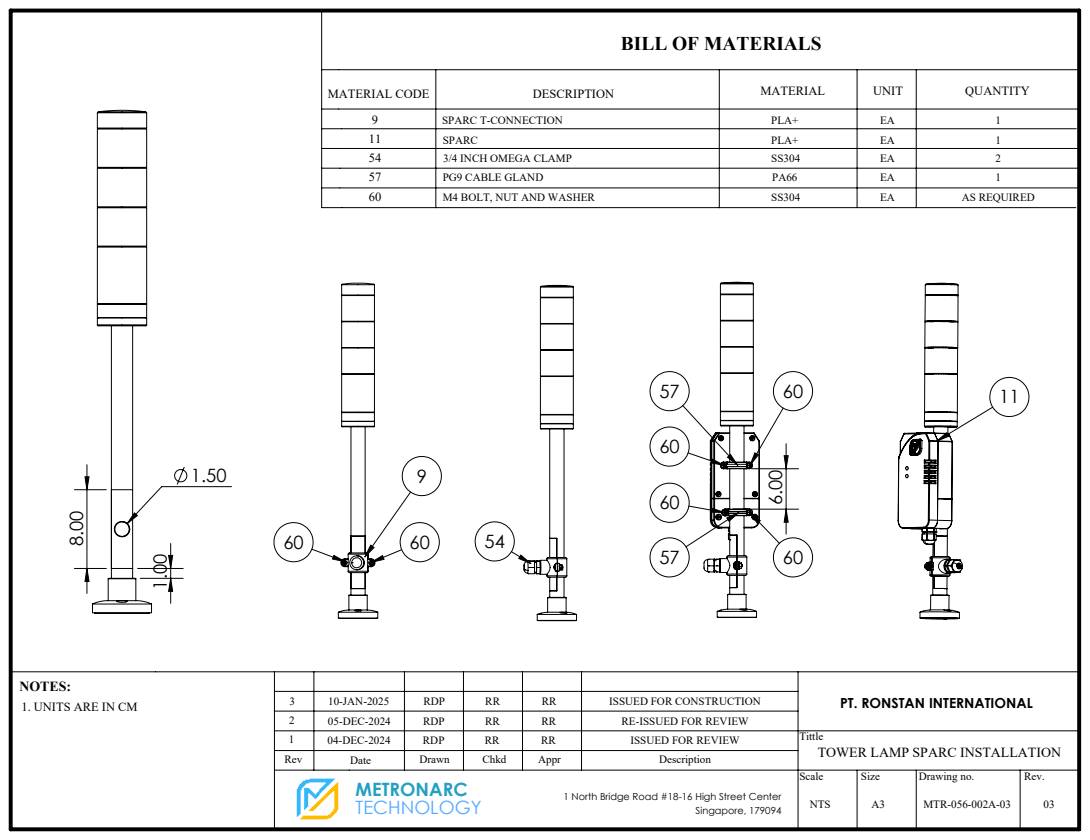
[picture p50: page 1]

BILL OF MATERIALS

MATERIAL CODE | DESCRIPTION | MATERIAL | UNIT | QUANTITY
9 | SPARC T-CONNECTION | PLA+ | EA | 1
11 | SPARC | PLA+ | EA | 1
54 | 3/4 INCH OMEGA CLAMP | SS304 | EA | 2
57 | PG9 CABLE GLAND | PA66 | EA | 1
60 | M4 BOLT, NUT AND WASHER | SS304 | EA | AS REQUIRED

NOTES: 1. UNITS ARE IN CM | PT. RONSTAN INTERNATIONAL

3 | 10-JAN-2025 | RDP | RR | RR | ISSUED FOR CONSTRUCTION
2 | 05-DEC-2024 | RDP | RR | RR | RE-ISSUED FOR REVIEW
1 | 04-DEC-2024 | RDP | RR | RR | ISSUED FOR REVIEW | Tittle TOWER LAMP SPARC INSTALLATION
Rev | Date | Drawn | Chkd | Appr | Description
METRONARC TECHNOLOGY 1 North Bridge Road #18-16 High Street Center Singapore, 179094 | Scale NTS | Size A3 | Drawing no. MTR-056-002A-03 | Rev. 03
