MetronARC/metronarc/DESIGN/CNC/Drawing/Drawing Instalation/MTR-056-002B-03.PDF

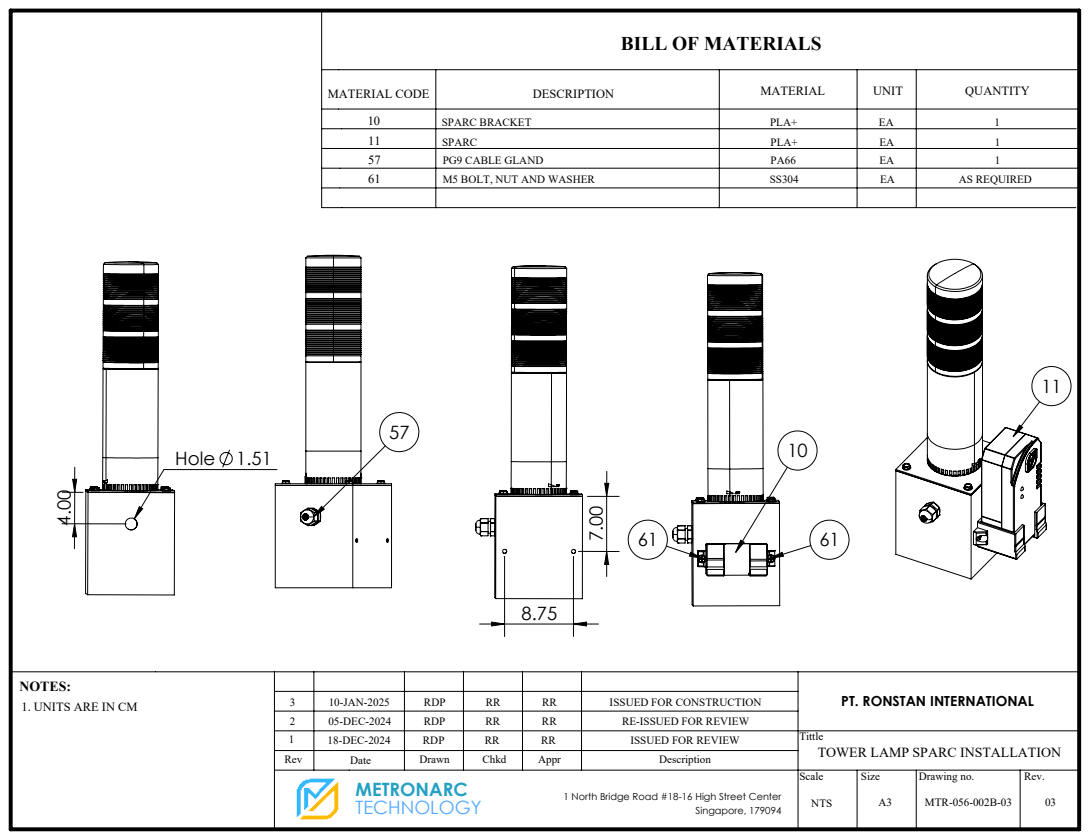
[picture p51: page 1]
Hole 1.51

BILL OF MATERIALS

MATERIAL CODE | DESCRIPTION | MATERIAL | UNIT | QUANTITY

10 | SPARC BRACKET | PLA+ | EA | 1
11 | SPARC | PLA+ | EA | 1
57 | PG9 CABLE GLAND | PA66 | EA | 1
61 | M5 BOLT, NUT AND WASHER | SS304 | EA | AS REQUIRED

NOTES: 1. UNITS ARE IN CM | PT. RONSTAN INTERNATIONAL

3 | 10-JAN-2025 | RDP | RR | RR | ISSUED FOR CONSTRUCTION
2 | 05-DEC-2024 | RDP | RR | RR | RE-ISSUED FOR REVIEW
1 | 18-DEC-2024 | RDP | RR | RR Appr | ISSUED FOR REVIEW | Tittle TOWER LAMP SPARC INSTALLATION
Rev | Date | Drawn | Chkd | | Description
METRONARC TECHNOLOGY 1 North Bridge Road #18-16 High Street Center Singapore, 179094 | Scale NTS | Size A3 | Drawing no. MTR-056-002B-03 | Rev. 03
