MetronARC/metronarc/PCB/SCHEMATIC/CNC without Transistor/REV SPARC CNC with battery.brd

## EAGLE design PCB/SCHEMATIC/CNC without Transistor/REV SPARC CNC with battery.brd (2024-10-23)

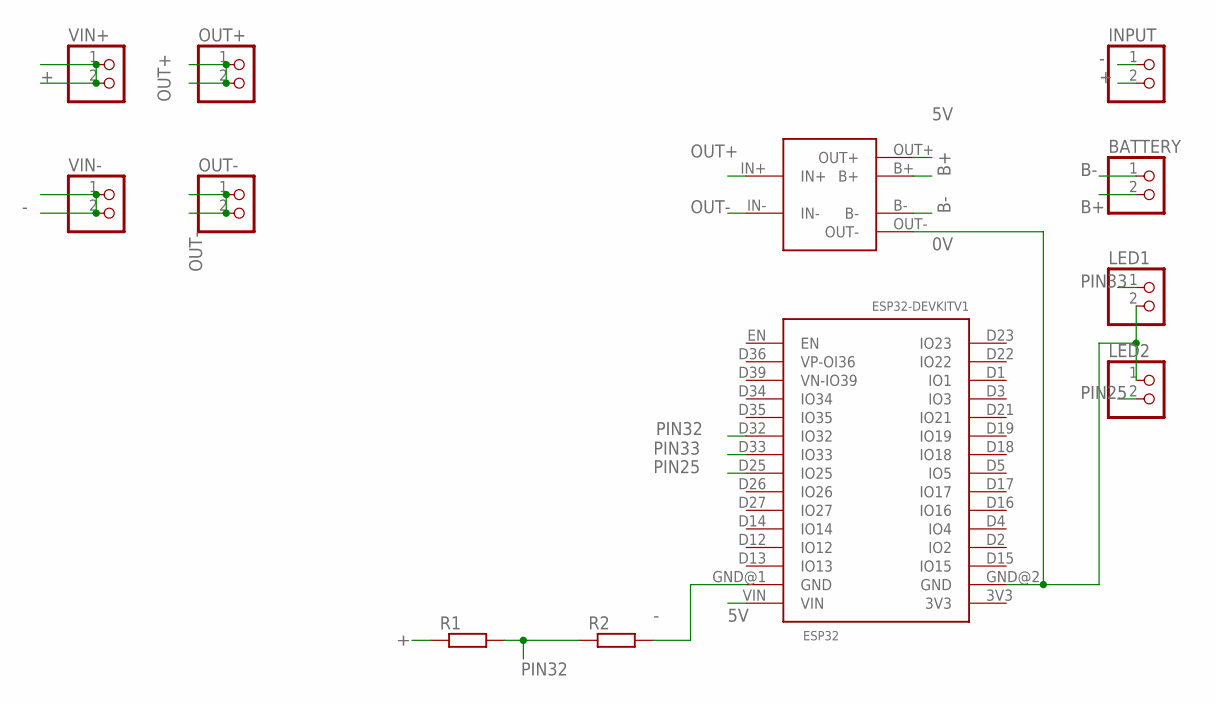
[picture p52: schematic REV SPARC CNC with battery.sch]

Parts:
BATTERY: PINHD-1X02_2.54; 1X02
ESP32: ESP32DEVKITV1; ESP32-DEVKITV1
INPUT: PINHD-1X2; 1X02
LED1, LED2: PINHD-1X2; 1X02
OUT+: PINHD-1X2; 1X02
OUT-: PINHD-1X2; 1X02
R1, R2: R-EU_0207/10; 0207/10
TP: TP4056-PTH
VIN+: PINHD-1X2; 1X02
VIN-: PINHD-1X2; 1X02

Connections:
0V: ESP32.GND@2 (GND), LED1.2, LED2.1, TP.OUT-
5V: ESP32.VIN, TP.OUT+
+: INPUT.2, R1.1, VIN+.1, VIN+.2
-: ESP32.GND@1 (GND), INPUT.1, R2.2, VIN-.1, VIN-.2
B+: BATTERY.2, TP.B+
B-: BATTERY.1, TP.B-
OUT+: OUT+.1, OUT+.2, TP.IN+
OUT-: OUT-.1, OUT-.2, TP.IN-
PIN25: ESP32.D25 (IO25), LED2.2
PIN32: ESP32.D32 (IO32), R1.2, R2.1
PIN33: ESP32.D33 (IO33), LED1.1

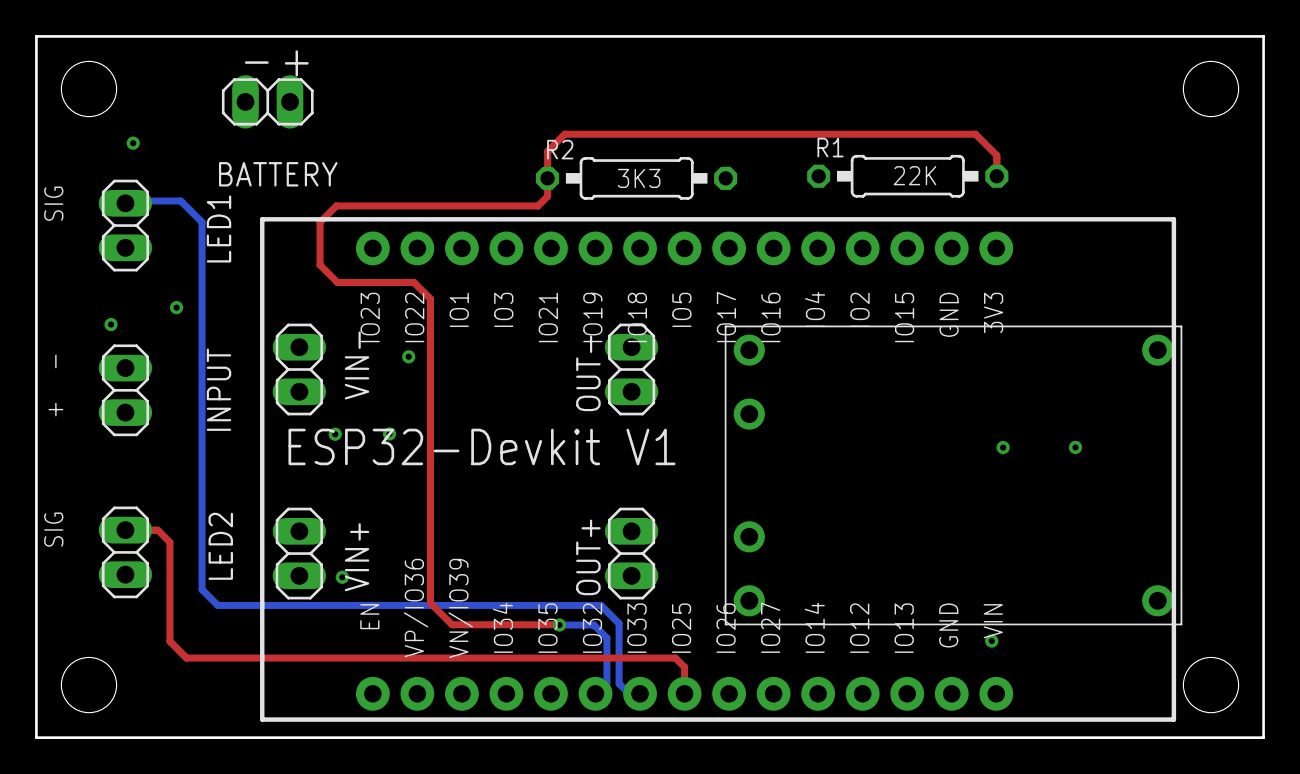
[picture p53: board REV SPARC CNC with battery.brd from above]

Board: 4 copper layers, 70.0 x 40.0 mm, 12 parts (0 on the bottom side), 11 nets.
