MetronARC/metronarc/PCB/SCHEMATIC/CNC NO BATTERY/SCHEMATIC/SPARK.brd

## EAGLE design PCB/SCHEMATIC/CNC NO BATTERY/SCHEMATIC/SPARK.brd (2024-09-09)

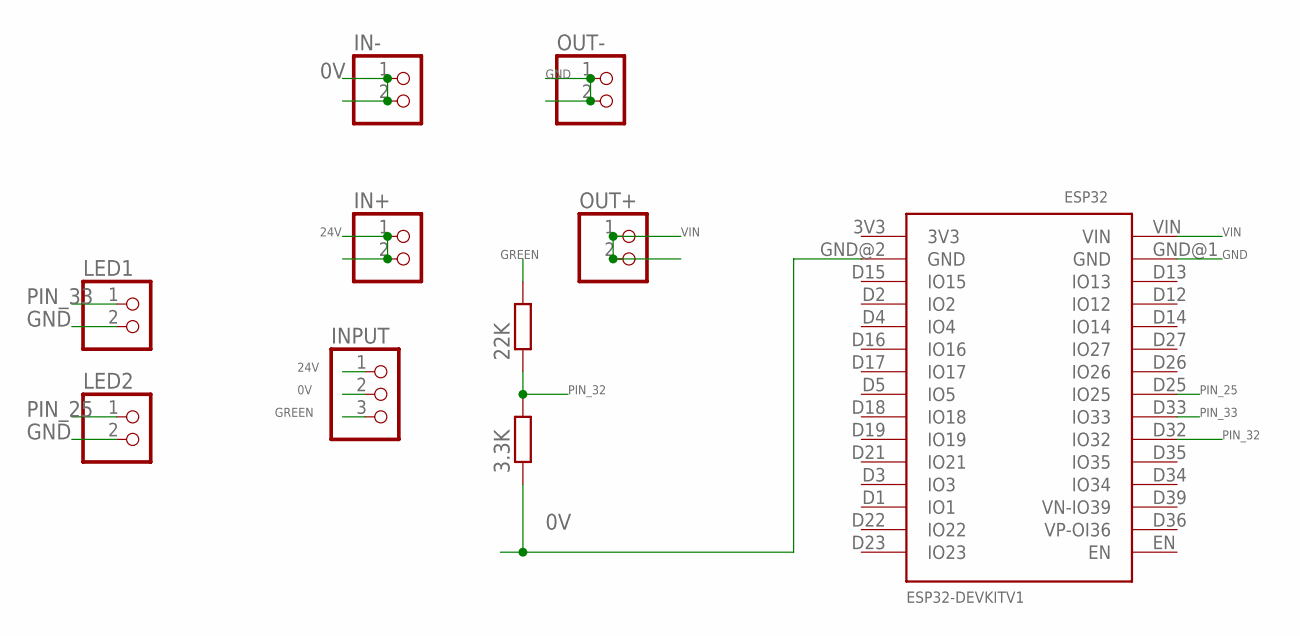
[picture p54: schematic SPARK.sch]

Parts:
3.3K, 22K: R-EU_0207/10; 0207/10
ESP32: ESP32DEVKITV1; ESP32-DEVKITV1
IN+: PINHD-1X2; 1X02
IN-: PINHD-1X2; 1X02
INPUT: PINHD-1X3; 1X03
LED1, LED2: PINHD-1X2; 1X02
OUT+: PINHD-1X2; 1X02
OUT-: PINHD-1X2; 1X02

Connections:
0V: 3.3K.1, ESP32.GND@2 (GND), IN-.1, IN-.2, INPUT.2
24V: IN+.1, IN+.2, INPUT.1
GND: ESP32.GND@1 (GND), LED1.2, LED2.2, OUT-.1, OUT-.2
GREEN: 22K.2, INPUT.3
PIN_25: ESP32.D25 (IO25), LED2.1
PIN_32: 3.3K.2, 22K.1, ESP32.D32 (IO32)
PIN_33: ESP32.D33 (IO33), LED1.1
VIN: ESP32.VIN, OUT+.1, OUT+.2

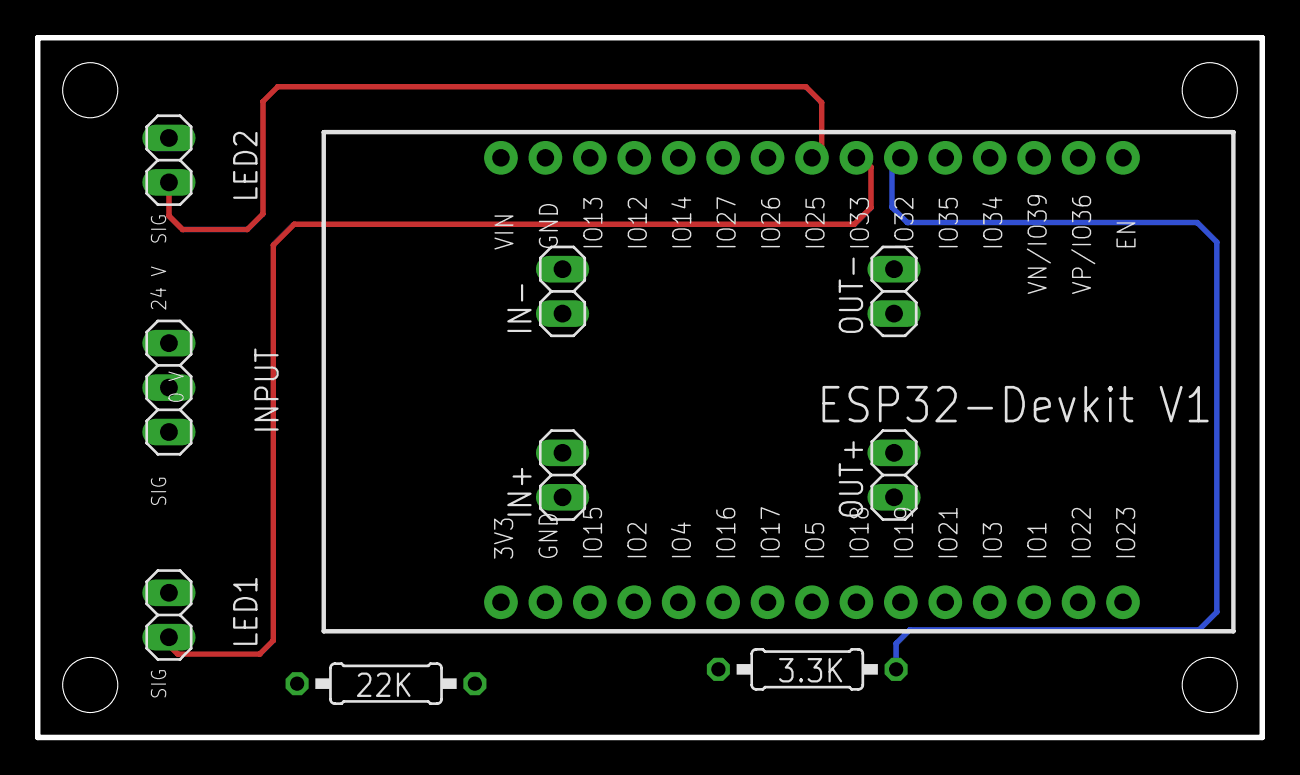
[picture p55: board SPARK.brd from above]

Board: 4 copper layers, 70.0 x 40.0 mm, 10 parts (0 on the bottom side), 8 nets.
