MetronARC/metronarc/PCB/SCHEMATIC/GAMMA/LED PCB/SPARC_Gamma LED PCB.brd

## EAGLE design PCB/SCHEMATIC/GAMMA/LED PCB/SPARC_Gamma LED PCB.brd (2024-09-09)

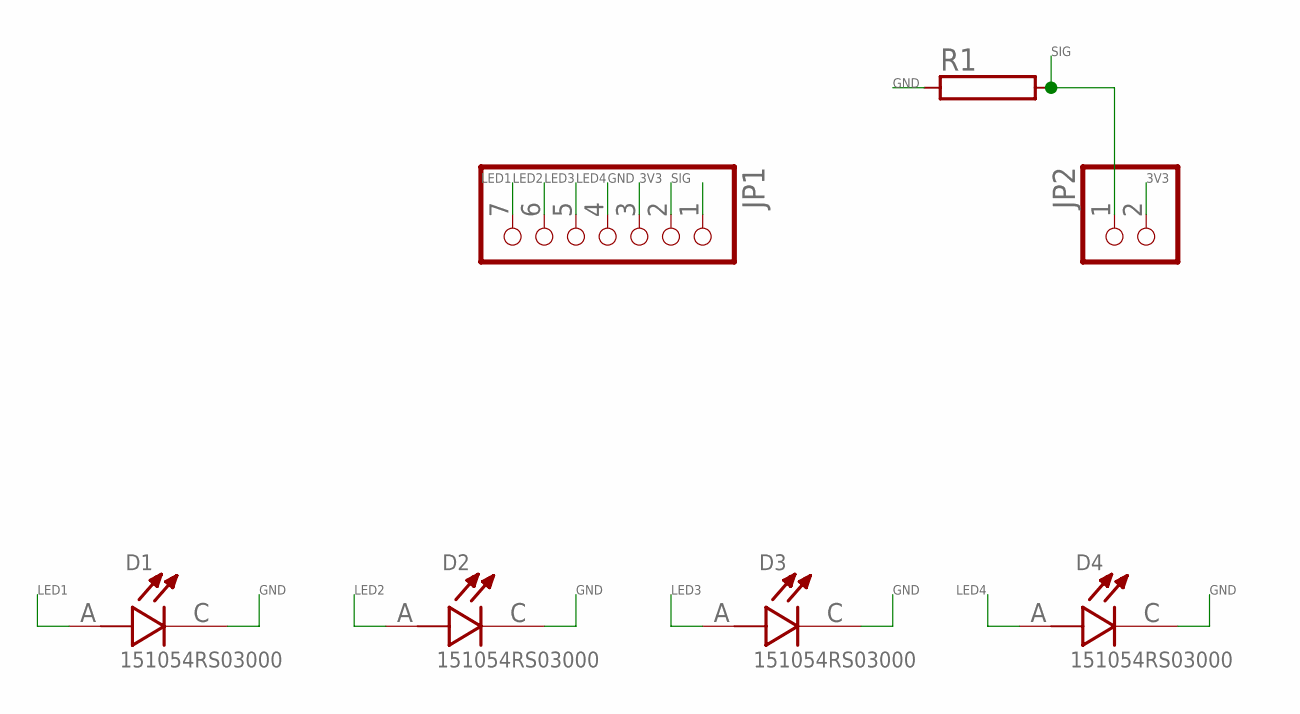
[picture p56: schematic SPARC_Gamma LED PCB.sch]

Parts:
D1, D2, D3, D4: 151054RS03000; LED_151054RS03000
JP1: PINHD-1X7; 1X07
JP2: PINHD-1X2; 1X02
R1: RAC01; AC01

Connections:
3V3: JP1.2, JP2.2
GND: D1.C, D2.C, D3.C, D4.C, JP1.3, R1.1
LED1: D1.A, JP1.7
LED2: D2.A, JP1.6
LED3: D3.A, JP1.5
LED4: D4.A, JP1.4
SIG: JP1.1, JP2.1, R1.2

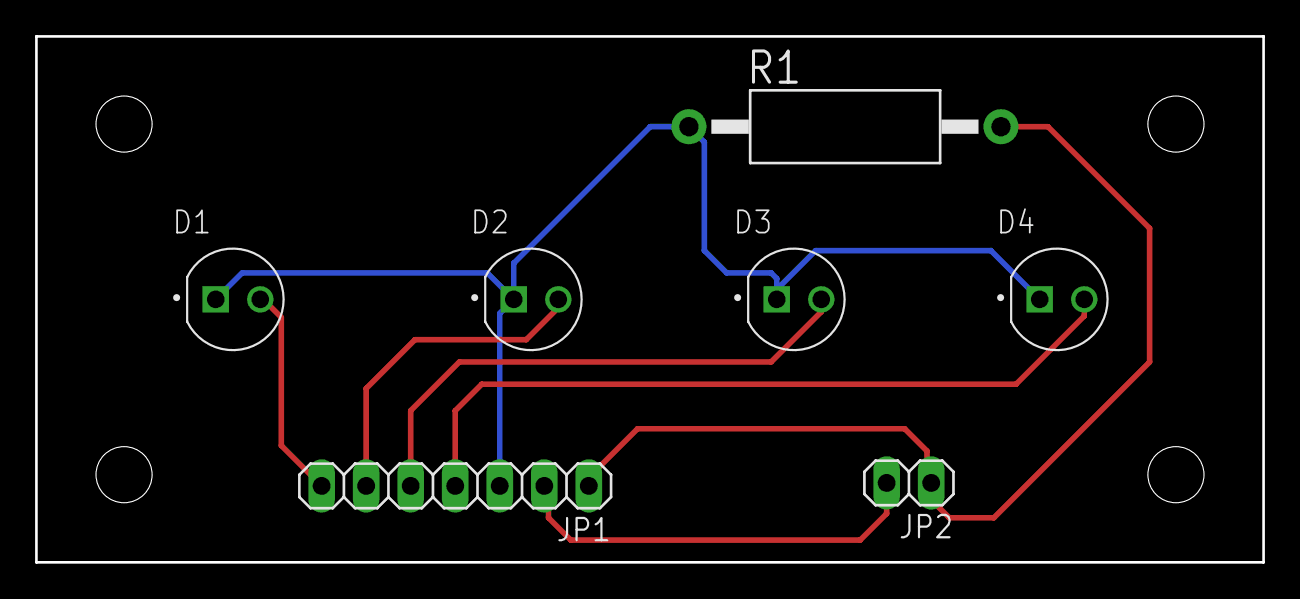
[picture p57: board SPARC_Gamma LED PCB.brd from above]

Board: 2 copper layers, 70.0 x 30.0 mm, 7 parts (0 on the bottom side), 7 nets.
