MetronARC/metronarc/PCB/SCHEMATIC/GAMMA/SCHEMATIC/SPARC Project Gamma_Schematic.brd

## EAGLE design PCB/SCHEMATIC/GAMMA/SCHEMATIC/SPARC Project Gamma_Schematic.brd (2024-09-09)

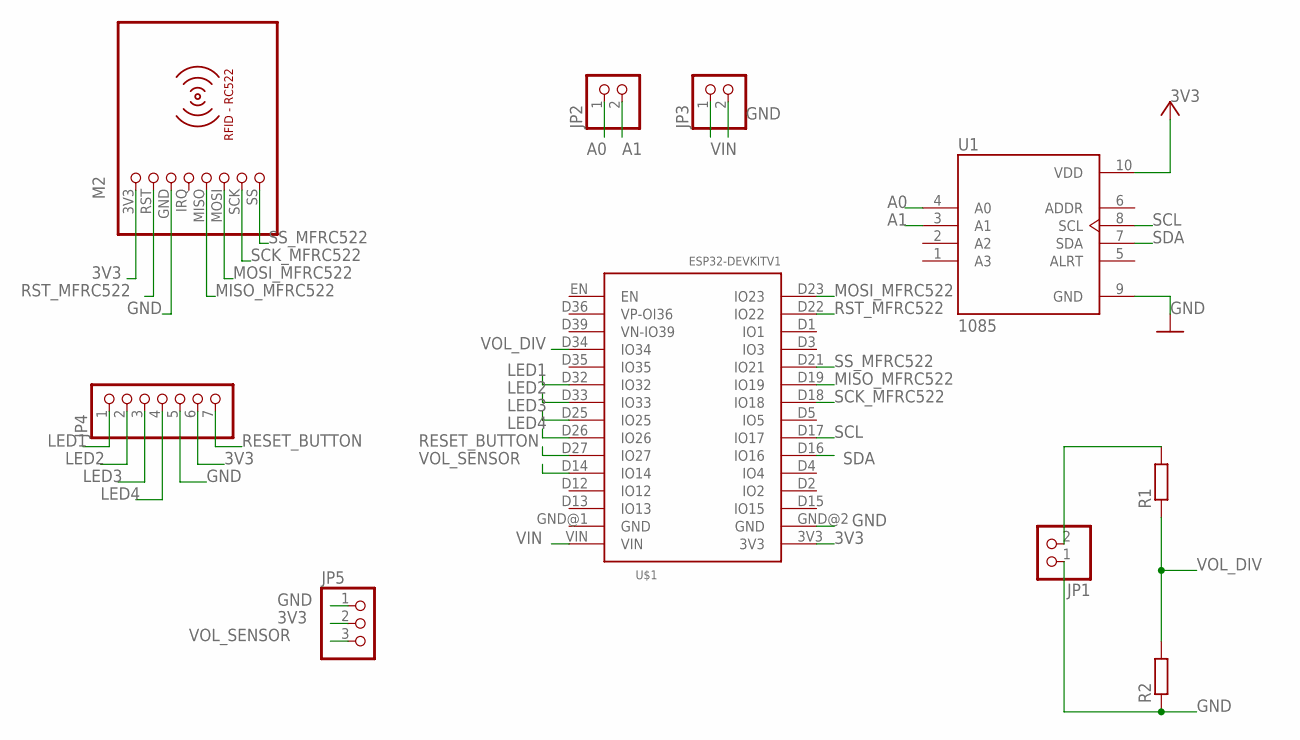
[picture p58: schematic SPARC Project Gamma_Schematic.sch]

Parts:
JP1, JP2, JP3: PINHD-1X2; 1X02
JP4: PINHD-1X7; 1X07
JP5: PINHD-1X3; 1X03
M2: RFID-RC522
R1, R2: R-EU_0204/2V; 0204V
U1: 1085; MODULE_1085
U$1: ESP32DEVKITV1; ESP32-DEVKITV1

Connections:
3V3: JP4.6, JP5.2, M2.3V3 (1), U1.10 (VDD), U$1.3V3
A0: JP2.1, U1.4 (A0)
A1: JP2.2, U1.3 (A1)
GND: JP1.1, JP3.2, JP4.5, JP5.1, M2.GND (3), R2.1, U1.9 (GND), U$1.GND@2 (GND)
LED1: JP4.1, U$1.D32 (IO32)
LED2: JP4.2, U$1.D33 (IO33)
LED3: JP4.3, U$1.D25 (IO25)
LED4: JP4.4, U$1.D26 (IO26)
MISO_MFRC522: M2.MISO (5), U$1.D19 (IO19)
MOSI_MFRC522: M2.MOSI (6), U$1.D23 (IO23)
unnamed: JP1.2, R1.2
RESET_BUTTON: JP4.7, U$1.D27 (IO27)
RST_MFRC522: M2.RST (2), U$1.D22 (IO22)
SCK_MFRC522: M2.SCK (7), U$1.D18 (IO18)
SCL: U1.8 (SCL), U$1.D17 (IO17)
SDA: U1.7 (SDA), U$1.D16 (IO16)
SS_MFRC522: M2.SS (8), U$1.D21 (IO21)
VIN: JP3.1, U$1.VIN
VOL_DIV: R1.1, R2.2, U$1.D34 (IO34)
VOL_SENSOR: JP5.3, U$1.D14 (IO14)

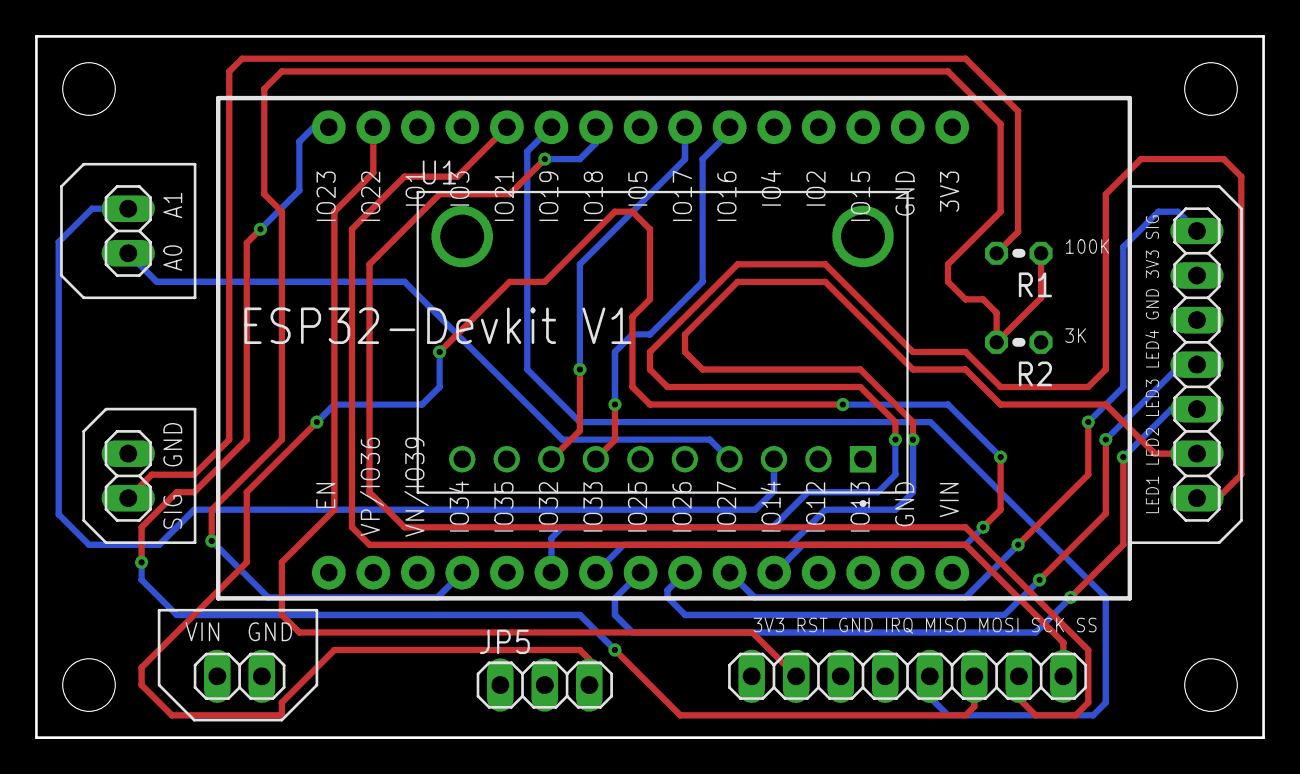
[picture p59: board SPARC Project Gamma_Schematic.brd from above]

Board: 4 copper layers, 70.0 x 40.0 mm, 10 parts (0 on the bottom side), 20 nets.
