MetronARC/metronarc/Source Code/Experiment/Rico/ESP32_NewLocalHost/images.h

#define images_width 64
#define images_height 64

const uint8_t PROGMEM images_bits[] = 
{
 0x00,0x00,0x00,0x00,0x00,0x00,0x00,0x00,0x00,0x00,0x00,0x00,
 0x00,0x00,0x00,0x00,0x00,0x00,0x00,0x00,0x00,0x00,0x80,0x0f,
 0x00,0x00,0x00,0x00,0x00,0x00,0xc0,0x1f,0x00,0x00,0x00,0x00,
 0x00,0x00,0x00,0x18,0x00,0x00,0x00,0x00,0x00,0x00,0x00,0x18,
 0x00,0x00,0x00,0x00,0x00,0x00,0x00,0x18,0x00,0xc0,0x00,0x00,
 0x00,0x00,0x03,0x18,0x00,0xe0,0x01,0x00,0x00,0x80,0x07,0x18,
 0x00,0xf0,0x00,0x00,0x00,0x00,0x0f,0x10,0x00,0x78,0x10,0x00,
 0x00,0x08,0x1e,0x00,0x00,0x38,0x38,0x00,0x00,0x1c,0x1c,0x00,
 0x00,0x3c,0x3c,0x00,0x00,0x3c,0x3c,0x00,0x00,0x1c,0x1e,0x02,
 0x40,0x78,0x38,0x00,0x00,0x1e,0x0f,0x07,0xe0,0x70,0x78,0x00,
 0x00,0x0e,0x8f,0x07,0xe0,0xf0,0x70,0x00,0x00,0x0e,0x87,0xff,
 0xff,0xe1,0x70,0x00,0x00,0x8f,0xc7,0x03,0xc0,0xe3,0xf1,0x00,
 0x00,0x87,0xc3,0x01,0xc0,0xc3,0xe1,0x00,0x00,0x87,0xc3,0x21,
 0x80,0xc3,0xe1,0x00,0x00,0x87,0xc3,0x51,0x80,0xc3,0xe1,0x00,
 0x00,0x87,0xc3,0x8d,0xb1,0xc3,0xe1,0x00,0x00,0x87,0xc3,0x01,
 0x8a,0xc3,0xe1,0x00,0x00,0x87,0xc3,0x01,0x84,0xc3,0xe1,0x00,
 0x00,0x87,0xc3,0x01,0xc0,0xe3,0xe1,0x00,0x00,0x8f,0xc7,0x03,
 0xc0,0xe1,0xf1,0x00,0x00,0x0e,0x87,0xff,0xff,0xe1,0x70,0x00,
 0x00,0x0e,0x0f,0x07,0xe0,0xf0,0x70,0x00,0x00,0x1e,0x0e,0x07,
 0xe0,0x70,0x78,0x00,0x00,0x1c,0x1e,0x00,0x00,0x78,0x38,0x00,
 0x00,0x3c,0x3c,0x00,0x00,0x3c,0x3c,0x00,0x00,0x78,0x38,0x00,
 0x00,0x1c,0x1e,0x00,0x00,0x78,0x10,0x00,0x00,0x08,0x1e,0x00,
 0x08,0xf0,0x00,0x00,0x00,0x00,0x0f,0x00,0x18,0xe0,0x00,0x00,
 0x00,0x80,0x07,0x00,0x18,0xc0,0x00,0x00,0x00,0x00,0x03,0x00,
 0x18,0x00,0x00,0x00,0x00,0x00,0x00,0x00,0x18,0x00,0x00,0x00,
 0x00,0x00,0x00,0x00,0x18,0x00,0x00,0x00,0x00,0x00,0x00,0x00,
 0xf8,0x03,0x00,0x00,0x00,0x00,0x00,0x00,0xf0,0x01,0x00,0x00,
 0x00,0x00,0x00,0x00,0x00,0x00,0x00,0x00,0x00,0x00,0x00,0x00,
 0x00,0x00,0x00,0x00,0x00,0x00,0x00,0x00,0x00,0x00,0x00,0x00,
 0x00,0x00,0x00,0x00,0x00,0x00,0x00,0x00,0x00,0x00,0x00,0x00,
 0xc0,0x01,0x1f,0xc0,0x01,0x3f,0x30,0x0c,0xe0,0x07,0x7f,0xe0,
 0x03,0x7f,0x30,0x0e,0x70,0x06,0x63,0xe0,0x03,0xe3,0x30,0x07,
 0x70,0x04,0xc3,0x60,0x03,0xc3,0x30,0x03,0xf0,0x00,0xe3,0x30,
 0x06,0x63,0xf0,0x01,0xe0,0x07,0x7f,0x30,0x06,0x3f,0xf0,0x01,
 0x00,0x07,0x3f,0xf0,0x07,0x3f,0xf0,0x03,0x10,0x0e,0x03,0xf8,
 0x0f,0x33,0x30,0x03,0x70,0x0e,0x03,0x18,0x0c,0x73,0x30,0x07,
 0xf0,0x07,0x03,0x18,0x0c,0xe3,0x30,0x0e,0xc0,0x01,0x03,0x18,
 0x0c,0xc3,0x30,0x0c,0x00,0x00,0x00,0x00,0x00,0x00,0x00,0x00,
 0xd8,0x4c,0xea,0xcc,0x29,0x19,0x56,0x06,0xf8,0xd2,0x4a,0x52,
 0x6a,0x05,0x51,0x01,0xa8,0x52,0x4b,0xd2,0xab,0x35,0x73,0x03,
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
};
