MetronARC/metronarc/(commit log)

2024-08-29 Design PCB CNC with battery
2024-08-30 3D PCB CNC with battery
2024-08-30 Added Schematic PCB CNC with Battery
    [SPARC CNC with battery.brd, SPARC CNC with battery.sch]
2024-09-06 upload design pcb
2024-09-06 Upload Design CNC STL
    [BASE.STL, Box Terminal.STL, TOP.STL, Top Box terminal.STL]
2024-09-09 added SPARC Gamma FIle
    [SPARC Project Gamma_Schematic.brd, SPARC Project Gamma_Schematic.sch, SPARC_Gamma LED PCB.brd, SPARC_Gamma LED PCB.sch, SPARC_Gamma_3D PCB Layout v2.stl]
2024-09-11 Update Revisi Design
    [BASE.STL, Box Terminal.STL, TOP.STL, Top Box terminal.STL]
2024-10-15 Upload STL design GAMMA
    [BASE.M REV2.STL, Drawing GAMA.SLDDRW, Spark .M REV2.STL, TOP.M REV2.STL]
2024-10-23 PCB CNC Battery without Transistor
    [REV SPARC CNC with battery.brd, REV SPARC CNC with battery.sch]
2024-11-25 Schematic wiring CNC and Gamma
2024-12-06 Upload Design Sparc-T Connection Left and Right
    [L_Con.STL, R_Con.STL]
2024-12-06 Update Drawing Schematic Sparc CNC
2024-12-10 Upload revisi1 Design Sparc-T connection
    [Rev1_L_Con.STL, Rev1_R_Con.STL]
2024-12-26 Upload Design Bracket for sparc CNC
    [Bracket.STL]
2024-12-26 Reupload Design bracket rev 1
    [Bracket.STL]
2025-01-10 upload revision for drawing instalation and wiring diagram
    [Draw CNC.SLDDRW, Drawing CNC.SLDDRW]
2025-02-06 Upload Design Mechanical for OILID Project
    [Gamma base.STL, Gamma top.STL]
2025-02-07 Upload PCB OILID MINI GAMMA
2025-02-19 Upload design Mini Gamma QR
    [BASE_Mini Gamma QR.STL, TOP_Mini Gamma QR.STL]
